ClearGrass/BranHardware/README.md

# BranHardware
BranHardware

## 2015-05-17

###Pinmap文件夹 存放管脚说明
###SCH   文件夹 存放原理图
