ClearGrass/BranHardware/11BRANBB70F/11BRANBB70F_20171028生产文件/11BRANBB70F_20171028制板要求.docx

主板制板需求

1. 单板尺寸：长*宽：30*27.45mm，严格按照Keepout layer层切割；
2. 层数： 两层板，2层，两面贴片；
3. 板厚：1MM，公差：±10%mm；
4. 材质：FR-4;
5. 铜箔厚度：完成铜厚1OZ；
6. 阻焊：字符颜色：白色；
7. 出货方式：拼板；
8. 过孔盖油；
9. 绿油阻焊；
10. 焊盘喷镀：沉金；
11. 测试：需要飞针测试；
12. 需要加贵司标记与年周；
13. 切割方式：VCUT；
14. Mark点生成需要做成如下：

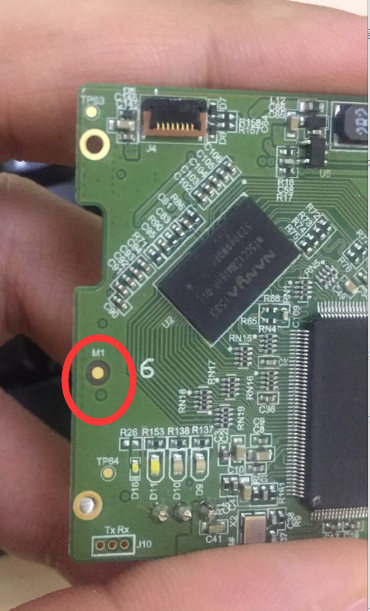
[picture p1: figure]

15. 拼板方式：

6*5;

设计参考拼板参考文件夹中的工作稿；主控板Mark点放在拼板短边一侧；

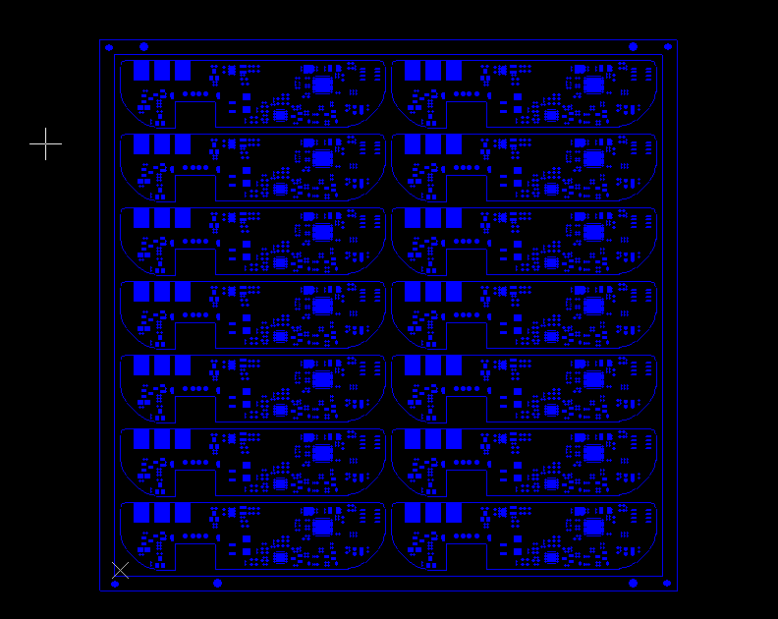
[picture p2: figure]

关于上述拼板文件，有几个问题点：

1） Mark点左下做防呆即可，其他三个Mark点距离板边的位置需要一致；
2） 定位孔需要距离板边距离一致；
3） 单板之间的间距可以参考拼板文件设计，但邮票孔换成VCUT；

另，添加以下其他要求：

1） 拼板文件需要将钻孔层工艺边的定位孔移至gtp以及gpb钢网文件中；
2） 如下图，需要在gto文件添加数量标示，从左至右以此类推。且gto与gpo文件需要加TOP和BOT丝印标记；

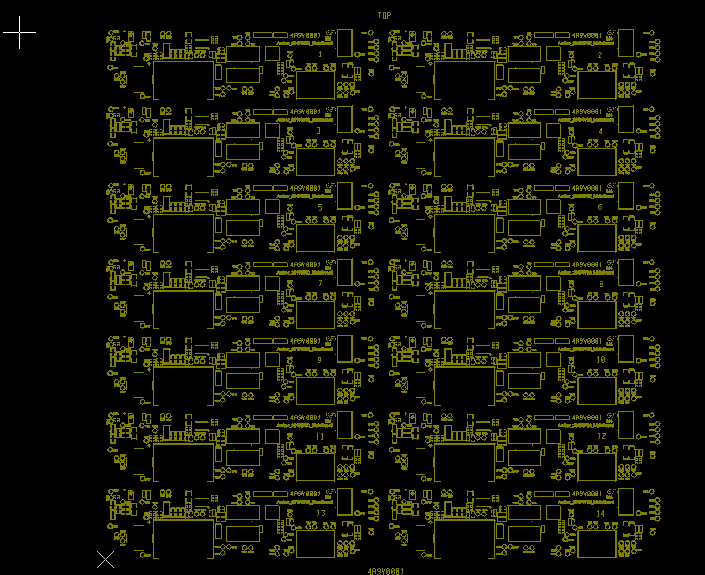
[picture p3: figure]

16. 出货方式：

拼板出货；

17. 数量：

与我司王丽娜确认。

18. 制板过程中若有疑问，请不要自行制板，请立刻联系我。谢谢！！

联系人：倪昭君，联系电话：15618636793；
