ClearGrass/BranHardware/11BRANBB70F/11BRANBB70F_20171028生产文件/变更说明.docx

1、仅图示三个定位孔直径变更，又1.2mm变更为1.05mm；

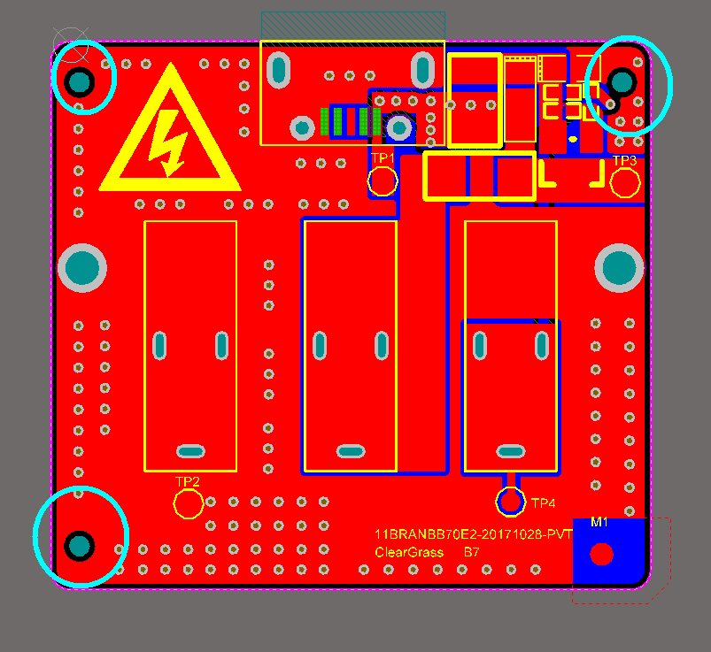
[picture p4: figure]

2、将板名称由11BRANBB70E改为11BRANBB70F
