ClearGrass/BranHardware/11BRANMB10H3/主板/11BRANMB10H3制板文件/制板要求.docx

主板制板需求:

1. 制程能力：

过孔：内径8mi，外径16mil，导线间距4mil；

2. 单板尺寸：长*宽：91.4*48mm，严格按照Keepout layer层切割；
3. 层数：六层板，两面贴片；

叠层结构：

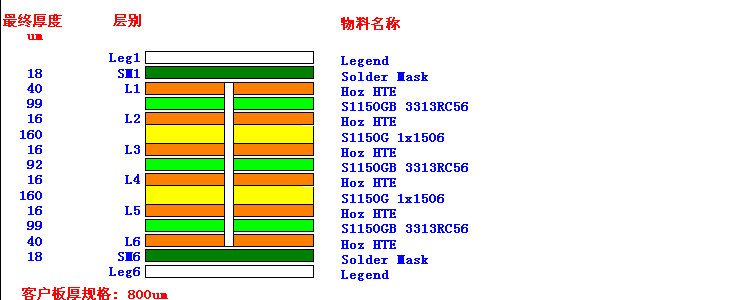
[picture p5: figure]

4. 板厚：0.8MM，公差：±10%mm；
5. 材质：FR-4; 无卤无铅；
6. 铜箔厚度：完成铜厚1OZ；
7. 字符颜色：白色；
8. 线路阻抗：必须按文件要求，无明确要求的可忽略；
9. 出货方式：拼板2*3 ,纵向间隔需要做2MM；
10. 过孔盖油；
11. 绿油阻焊；
12. 焊盘喷镀：沉金；
13. 测试：需要飞针测试；
14. 需要加贵司标记与年周；
15. 切割方式：邮票孔连筋；
16. 拼板方式：

参考拼板参考Gerber6e160885h0文件夹内工作稿；

设计参考《拼板设计》文件；主控板Mark点放在拼板短边一侧；


关于上述拼板文件，有几个问题点：

1） Mark点左下做防呆即可，其他三个Mark点距离板边的位置需要一致；
2） 定位孔需要距离板边距离一致；
3） 单板之间的间距可以参考拼板文件设计，但邮票孔换成VCUT；

另，添加以下其他要求：

1） 拼板文件需要将钻孔层工艺边的定位孔移至gtp以及gpb钢网文件中；
2） 如下图，需要在gto文件添加数量标示，从左至右以此类推。且gto与gpo文件需要加TOP和BOT丝印标记；


17. 出货方式：

拼板出货；

18. 数量：

10Pcs；

19. 制板过程中若有疑问，请不要自行制板，请立刻联系我。谢谢！！

联系人：倪昭君，联系电话：15618636793；
