ClearGrass/BranHardware/11BRANMB10H3/温湿度FPC/11BRANSEB30E2_20171028制板文件/变更记录.docx

1、 为配合H3版本结构更改，新设计的一款温湿度FPC;
2、 尺寸由：L*W=24.889*7.236变更为：L*W=19.903*7mm;
3、 附图

旧：

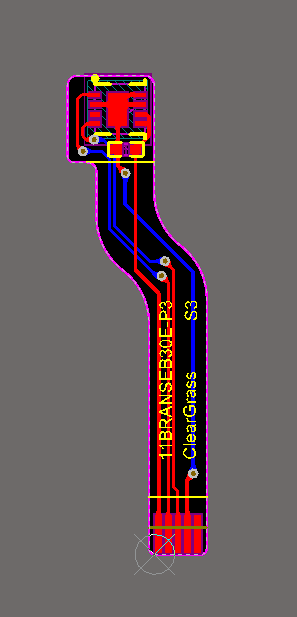
[picture p7: figure]

新：

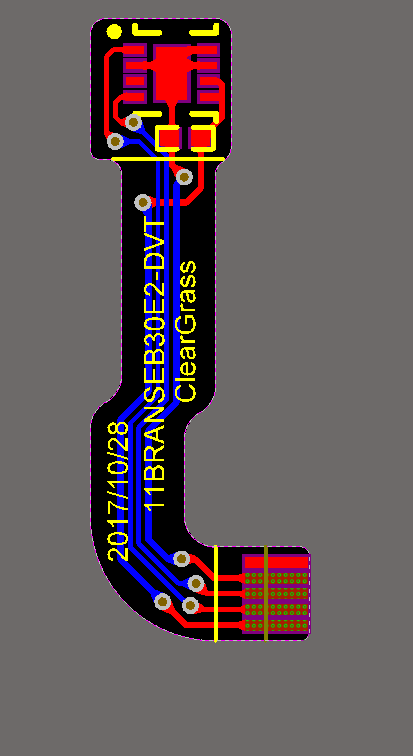
[picture p8: figure]
