ClearGrass/BranHardware/11BRANMB10G/Temp Sensirion assy FPC/结构/外接传感器.pptx

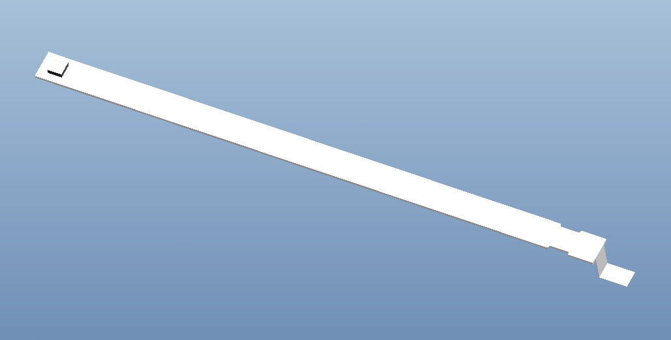
[picture p9: figure]

传感器位置

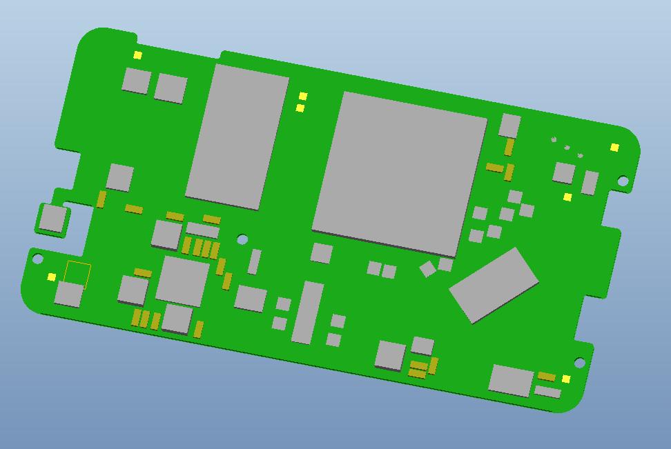
[picture p10: figure]

卡槽

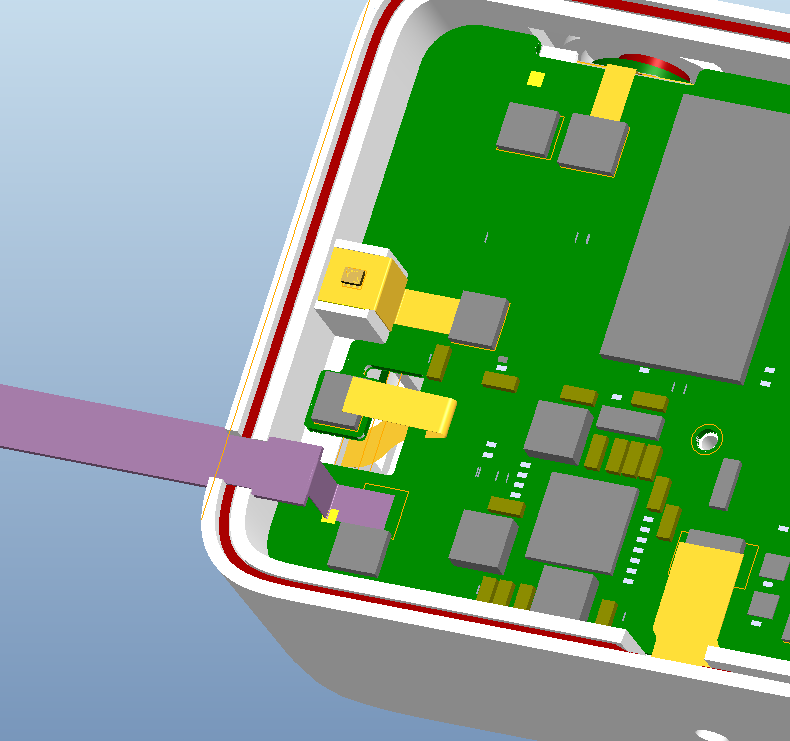
[picture p11: figure]

补强板长度100mm，宽度5mm
卡槽处与产品外壳开口处固定，屏幕压紧
防止FPC连接器脱落

连接器位置

## Slide 2

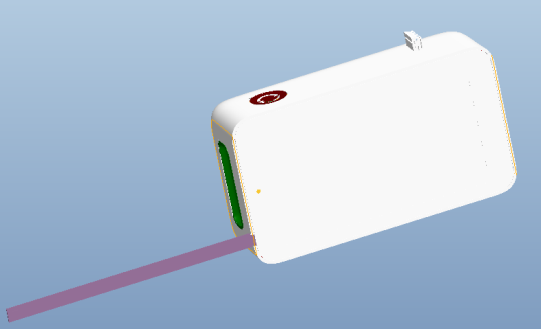
[picture p12: figure]
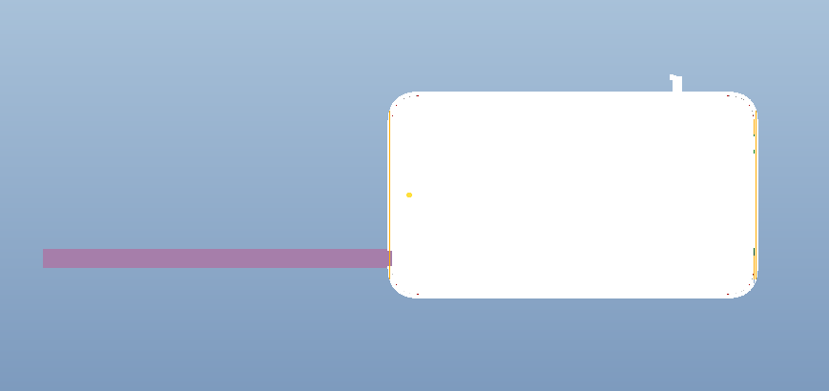
[picture p13: figure]

91mm

10mm

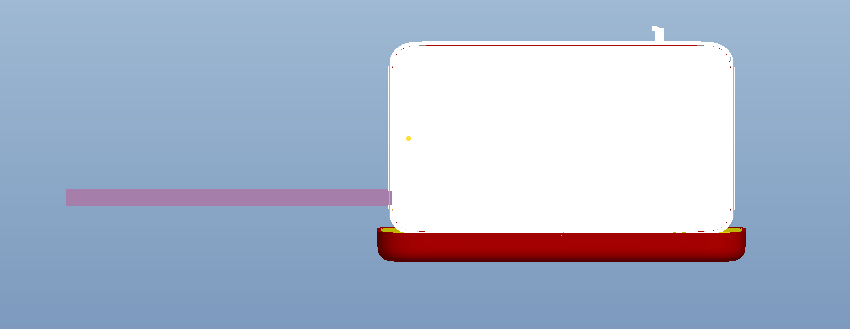
[picture p14: figure]

18mm
