ClearGrass/BranHardware/11BRANMB10H3/主板/11BRANMB10H3制板文件/阻抗匹配要求.docx

一、 差分：

1）95±10% ohm阻抗匹配：

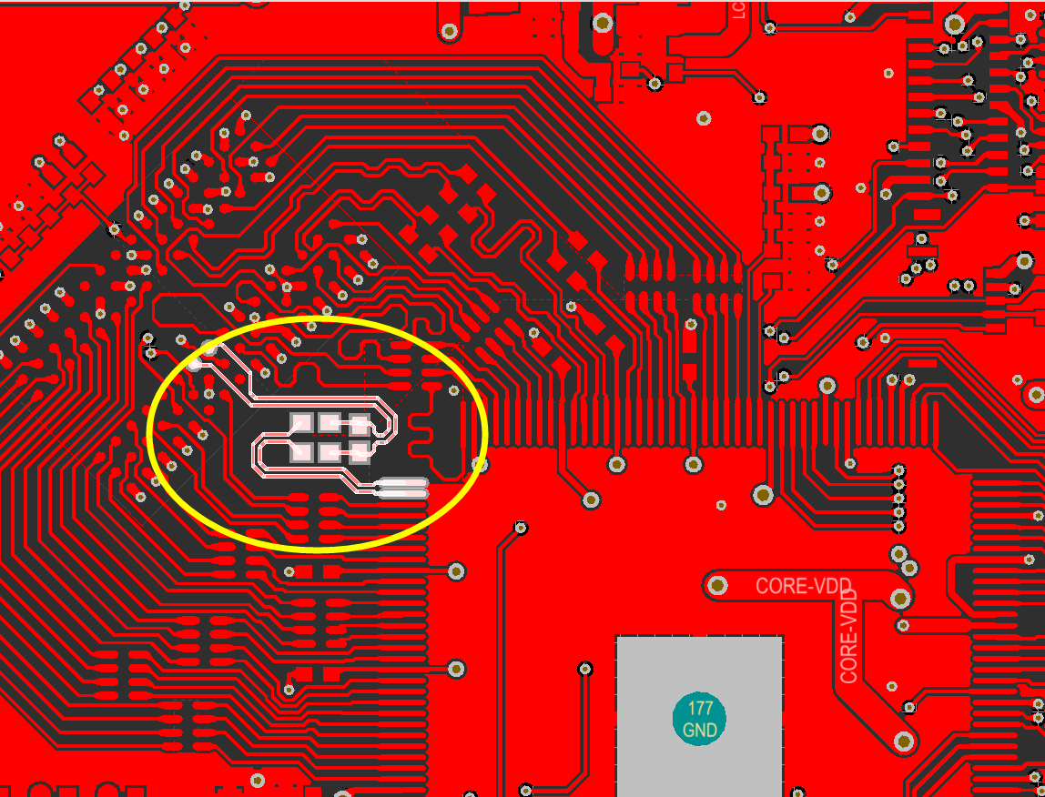
[picture p23: figure]

2）

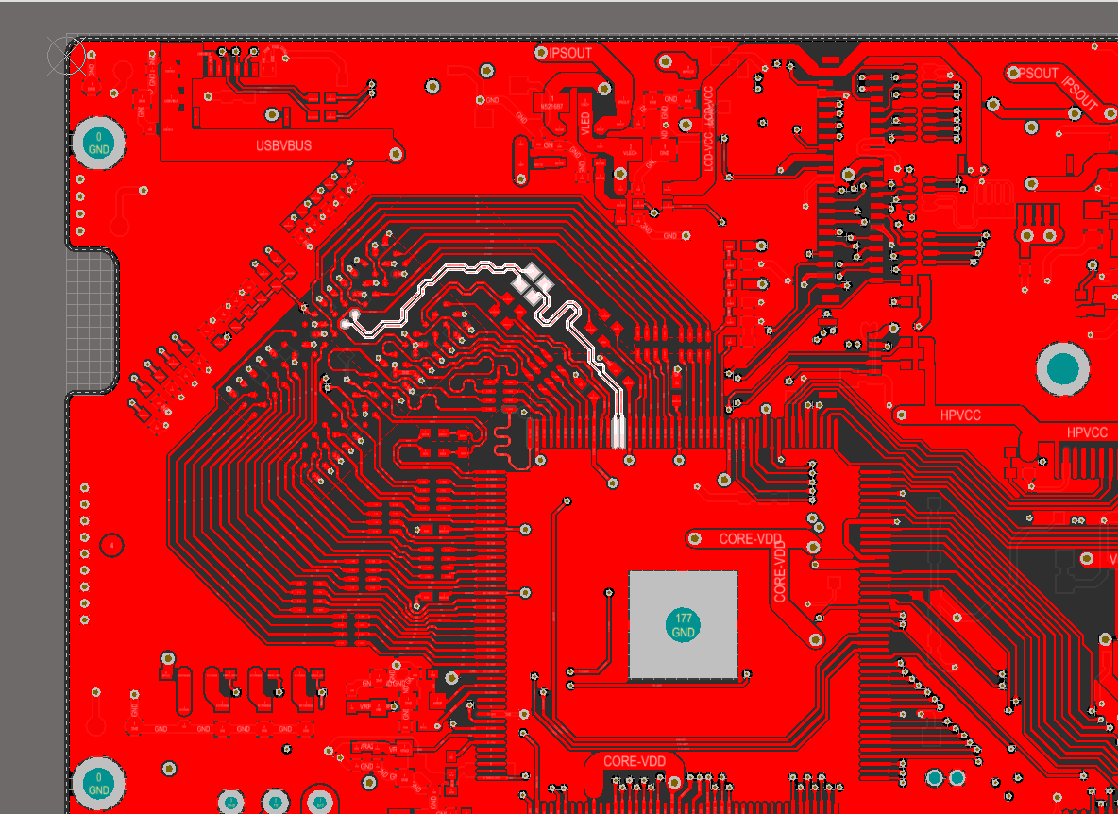
[picture p24: figure]

3）

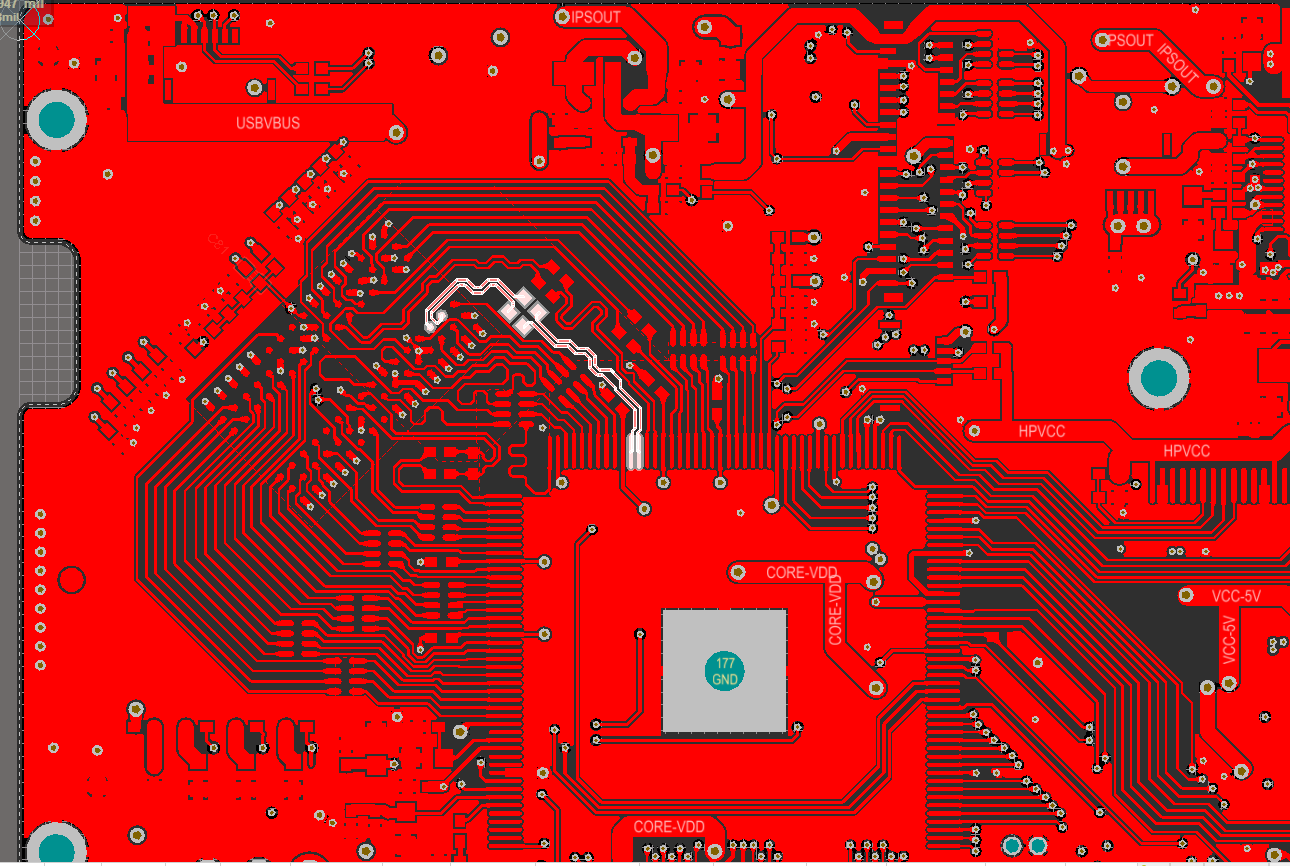
[picture p25: figure]

2. 90±10% ohm阻抗匹配：

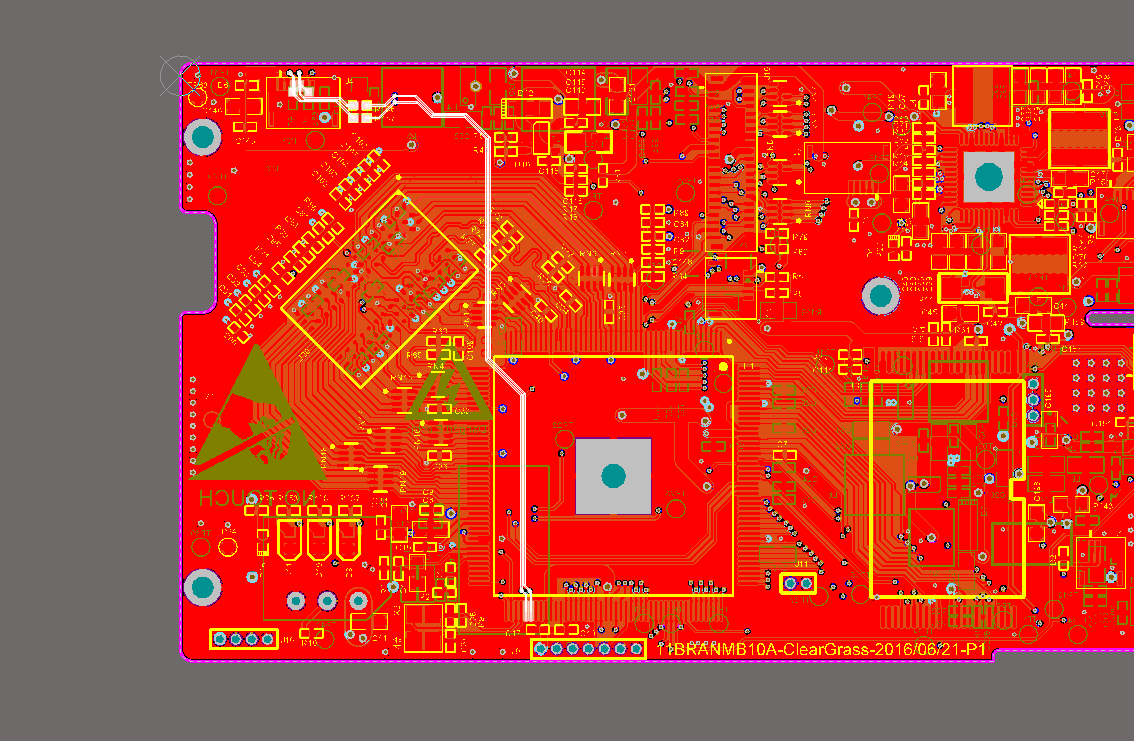
[picture p26: figure]

二、单端阻抗匹配

1. 45±10% ohm；

1）内存部分：

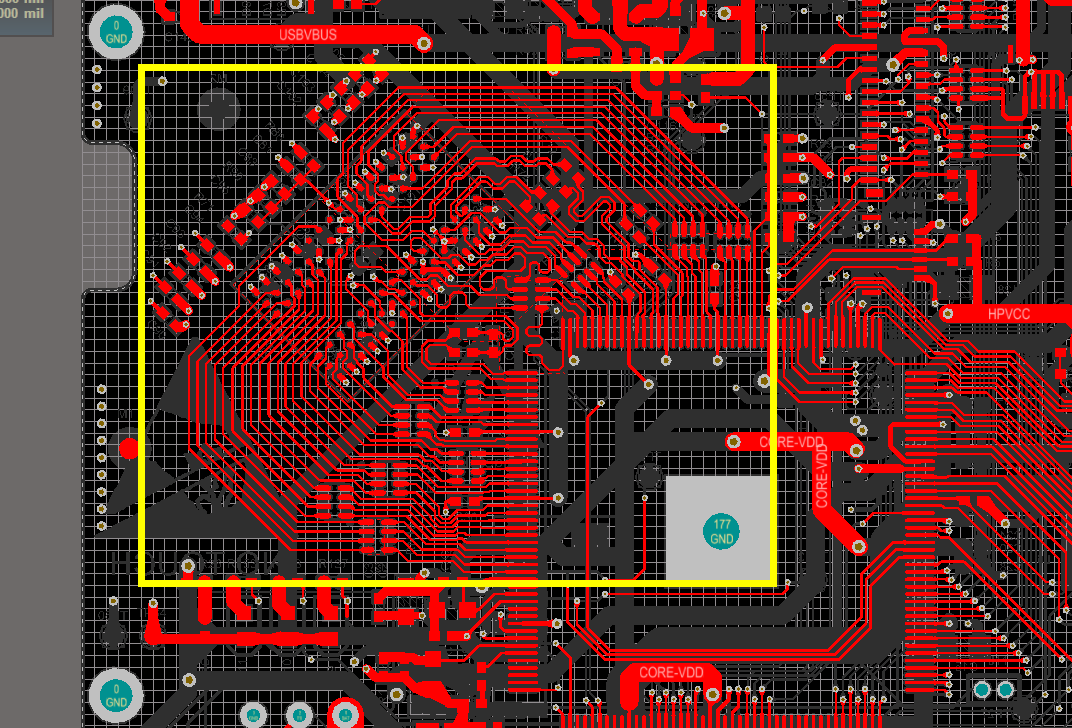
[picture p27: figure]

2）SDIO部分：

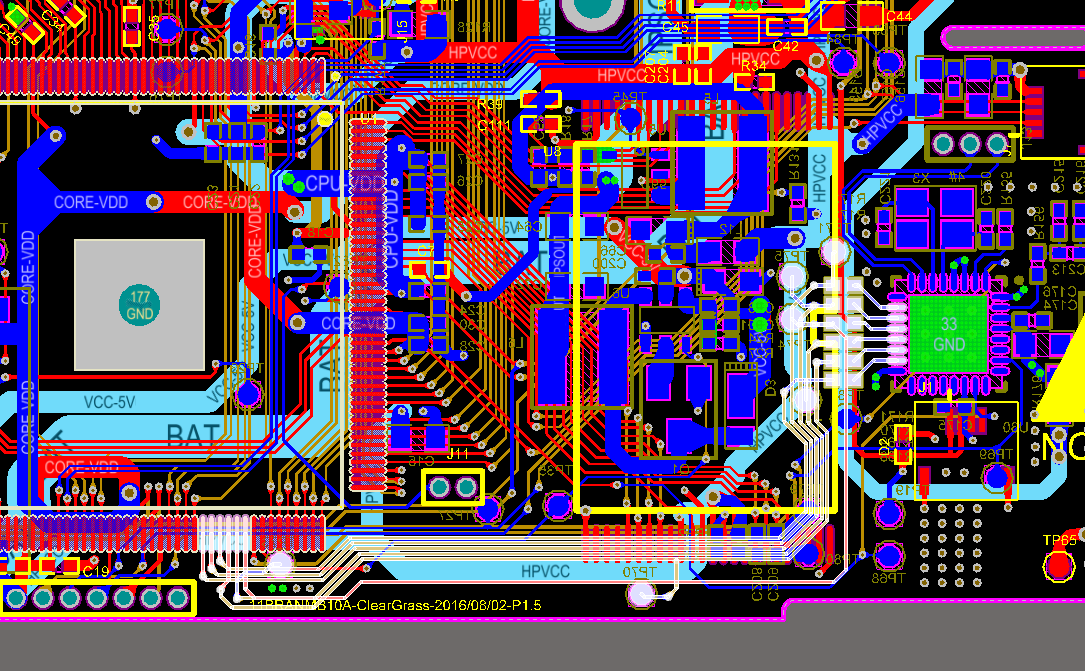
[picture p28: figure]

2. 50±10% ohm；

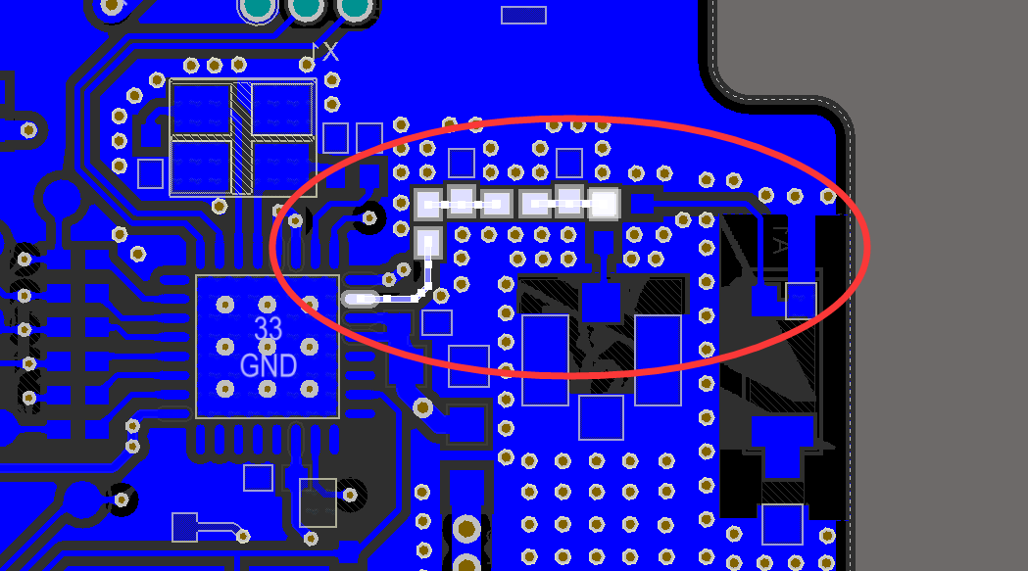
[picture p29: figure]
