ClearGrass/BranHardware/11BRANMB10G/11BRANMB10GSMT文件/01BOM/Bran SMT BOM20170921.xlsx

Sheet: SMT MB BOM
青萍科技（北京）有限公司
BILL OF MATERIAL
DOCUMENT NO. |  | BRAN_007 |  | HWID | N/A |  | AUTHOR |  | REV. | G
Product Name |  | BRAN |  | SWID | N/A |  | BOM Type |  | DATE | 2017-09-21
Item | ClearGrass P/N | 中文品名 | 商品编码 | Description |  | Supplier P/N | Supplier | Usage | Location | Weight (mg/pcs) | Critical Component
0 | 11BRANMB10G | 主板 |  | MB_ASSY_Rev.G/DVT |  |  | 卓达 | 1
1 | R0000R0402 | 电阻 |  | 0402 Jump |  | WR04X000 PTL | walsin | 6 | R2,R9,R151,R158,R156,R157,
2 | R0001R0402 | 电阻 |  | 0402 1R00 1% |  | WR04W1R00FTL | walsin | 2 | R14,R15
3 | R04R990402 | 电阻 |  | 0402 4R99 1% |  | WR04W4R99FTL | walsin | 1 | R50
4 | R0024R0402 | 电阻 |  | 0402 24R0 1% |  | WR04X24R0FTL | walsin | 8 | R65,R68,R72,R73,R74,R75,R76,R77
5 | R0033R0402 | 电阻 |  | 0402 33R0 1% |  | WR04X33R0FTL | walsin | 4 | R44,R45,R46,R54
6 | R0200R0402 | 电阻 |  | 0402 200R 1% |  | WR04X2000FTL | walsin | 6 | R168,R169,R170,R171,R172,R173
7 | R0240R0402 | 电阻 |  | 0402 240R 1% |  | WR04X2400FTL | walsin | 2 | R71,R94
8 | R0510R0402 | 电阻 |  | 0402 510R 1% |  | WR04X5100FTL | walsin | 1 | R28
9 | R0001K0402 | 电阻 |  | 0402 1K00 1% |  | WR04X1001FTL | walsin | 4 | R3,R4,R22,R177
10 | R0002K0402 | 电阻 |  | 0402 2K00 1% |  | WR04X2001FTL | walsin | 4 | R86,R89,R90,R91
11 | R002K20402 | 电阻 |  | 0402 2K20 1% |  | WR04X2201FTL | walsin | 2 | R5,R6
12 | R004K70402 | 电阻 |  | 0402 4K70 1% |  | WR04X4701FTL | walsin | 2 | R7,R8
13 | R0010K0402 | 电阻 |  | 0402 10K0 1% |  | WR04X1002FTL | walsin | 16 | R34,R39,R55,R79,R80,R81,R99,R129,R130,R131,R179，R194，R196,R197,R199,R209
14 | R0012K0402 | 电阻 |  | 0402 12K0 1% |  | WR04X1202FTL | walsin | 1 | R155
15 | R0047K0402 | 电阻 |  | 0402 47K0 1% |  | WR04X4702FTL | walsin | 2 | R21,R23,~~R211~~ | `
16 | R0100K0402 | 电阻 |  | 0402 100K 1% |  | WR04X1003FTL | walsin | 5 | R12,R17,R180,R190,R181
17 | R0150K0402 | 电阻 |  | 0402 150K 1% |  | WR04X1503FTL | walsin | 1 | R13
18 | R0200K0402 | 电阻 |  | 0402 200K 1% |  | WR04X2003FTL | walsin | 3 | R1,R19,R188
19 | R0442K0402 | 电阻 |  | 0402 442K 1% |  | WR04X4423FTL | walsin | 1 | R18
20 | R001M80402 | 电阻 |  | 0402 1.8M 1% |  | WR04W1804FTL | walsin | 1 | R189
21 | R0000R0603 | 电阻 |  | 0603 Jump |  | WR06X000 PTL | walsin | 5 | R160,R176，R195，R198，R213
22 | R030MR1206 | 电阻 |  | 1206 R030 1% |  | WW12WR030FTL | walsin | 1 | R11
23 | RA024R0402 | 电阻 |  | 044R 24R0 1% |  | WA04X24R0FTL | walsin | 4 | RN1,RN3,RN5,RN6
24 | RA033R0402 | 电阻 |  | 044R 33R0 1% |  | WA04X33R0FTL | walsin | 6 | RN4,RN15,RN16,RN17,RN18,RN19
25 | RA100R0402 | 电阻 |  | 044R 100R 1% |  | WA04X1000FTL | walsin | 6 | RN2,RN7,RN8,RN9,RN10,RN11
26 | C006P80402 | 电容 |  | 0402 NPO 6.8pF +-0.25F 50V |  | 0402N6R8C500CT | walsin | 1 | C213
27 | C002P40402 | 电容 |  | 0402 NPO 2.4pF +-0.25pF 50V |  | 0402N2R4C500CT | walsin | 1 | C216
28 | C003P30402 | 电容 |  | 0402 NPO 3.3pF +-0.25pF 50V |  | 0402N3R3C500CT | walsin | 2 | C220,C221
29 | C0010P0402 | 电容 |  | 0402 NPO 10pF +-5% 50V |  | 0402N100J500CT | walsin | 1 | C109
30 | C0018P0402 | 电容 |  | 0402 NPO 18pF +-1% 50V |  | 0402N180F500CT | walsin | 2 | C37,C38
31 | C0047P0402 | 电容 |  | 0402 NPO 47pF +-5% 50V |  | 0402N470J500CT | walsin | 2 | C43,C58
32 | C0001N0402 | 电容 |  | 0402 X7R 1000pF +-5% 50V |  | 0402B102J500CT | walsin | 3 | C48,C56,C70
33 | C0010N0402 | 电容 |  | 0402 10nF +-5% 50V |  | 0402B103K500CT | walsin | 3 | C51,C65,C237
34 | C100N7R0402 | 电容 |  | 0402 X7R 100nF +-10% 10V |  | 0402B104K100CT | walsin | 61 | C3,C5,C7,C9,C10,C17,C19,C24,C25,C26,C27,C29,C30,C31,C35,C36,C81,C82,C83,C84,C85,C86,C87,C88,C89,C90,C91,C92,C93,C94,C95,C96,C97,C98,C99,C100,C101,C102,C103,C104,C105,C106,C111,C120,C123,C145,C148,C154,C156,C158,C176,C207,C209，C227，C228,C240,C241,C242,C248,C238，C253
35 | C100N5R0402 | 电容 |  | 1005（0402） X5R 100nF +-10% 50V |  | GRM155R61H104KE14D | murata | 1 | C116
36 | C01U5R0402 | 电容 |  | 0402 X5R 1000nF +-10% 10V |  | 0402X105K100CT | walsin | 21 | C1,C16,C18,C21,C22,C23,C28,C33,C34,C42,C49，C59,C60,C62,C71,C117,C175,C235,C236,C204，C208,
37 | C4U75R0603 | 电容 |  | 0603 X5R 4700nF +-10% 10V |  | 0603X475K100CT | walsin | 18 | C4,C15,C20,C39,C41,,C50,C61,C63,C64,C67,C69,C142,C146,C152,C155,C157,C249,C252
38 | C10U5R0603 | 电容 |  | 0603 X5R 10uF +-10% 10V |  | 0603X106K100CT | walsin | 17 | C2,C8,C40,C44,C45,C46,C47,C53,C54,C55,C57,C68,C121,C122,C174，C225，C251
39 | CT10U7R0603 | 钽电容 |  | TCM1A106M8R-O2 |  | TCM1A106M8R-O2 | ROHM | 1 | C52
40 | CT22U7R0603 | 钽电容 |  | TCSM1A226M8R-02 |  | TCSM1A226M8R | ROHM | 3 | C66,C159,C226
41 | L002NH0402 | 电感 |  | MLCI1005（0402）2.0nH +-0.1nH |  | WLCM1005Z0B2N0TB | walsin | 1 | C215
42 | L02UH24018 | 电感 |  | 4018 2.2uH +-20% 3A 45mR |  | MNR-4018-2R2M-L-XW | Mag | 4 | L1,L3,L5,L18
43 | L04UH74018 | 电感 |  | 4018 4.7uH +-20% 2.0A 70mR |  | MNR-4018-4R7M-H-XW | Mag | 2 | L2,L4
44 | L0100UH4018 | 电感 |  | 4018 10uH +-20% 1.3A 170mR |  | MNR-4018-100M-I-XW | Mag | 1 | L7
45 | L01A30603 | 磁珠 |  | 空白（BLM18KG601SN1D） |  | BLM18KG601SN1D | murata | 3 | L12,L13,L19
46 | D10MA1006 | 肖特基二极管 |  | RB160VAM-40TR |  | TUMD2M_RB160VAM-40TR | ROHM | 2 | D12，D18
47 | D03P106037 | TVS二极管 |  | VMNZC6.8CM8XT2R |  | VMNZC6.8CST2RA | ROHM | 2 | D7,D8
48 | DESD6V0201 | TVS二极管 |  | VS5V0BC1EST15R |  | VS5V0BC1EST15R | ROHM | 6 | D2,D4,D13,D15,D19，D20
49 | DESD9V2SOD123 | TVS二极管 |  | RSA5M |  | RSA5M | ROHM | 3 | D5,D6,D14
50 | A2450M3216 | 天线 |  | 3216 Type Antenna |  | RFECA3216060A1T | walsin | 1 | A1
51 | CN37361FPC | 连接器 |  | 046298704220883+（FPC_CONNECTOR_Bottom_0.5MM_3.7*3.6*1） |  | 046298704220883+ | 京瓷 | 1 | J1
52 | CN42361FPC | 连接器 |  | 5034800500 |  | 503480-0500 | Molex | 4 | J5,J7,J17，J18
53 | CN47361FPC | 连接器 |  | 5034800600 |  | 503480-0600 | Molex | 1 | J3
54 | CN39260BTB | 连接器 |  | 5035520620 |  | 5035480620 | Molex | 1 | J15
55 | CN57361FPC | 连接器 |  | 046298708220883+（FPC_CONNECTOR_Bottom_0.5MM_5.7*3.6*1） |  | 046298708220883+ | 京瓷 | 1 | J4
56 | CN10020BTB | 连接器 |  | 5033044240 |  | 5033044240 | Molex | 1 | J16
57 | CN10535FPC | 连接器 |  | 046298708220883+（WTB_CONNECTOR_10.5*3.5*4.5） |  | CI1506M1HR0-NH | 瀚荃股份 | 1 | J6
58 | CN16742FPC | 连接器 |  | 2581WR3- |  | S3B-EH | JST | 1 | J2
59 | ICCPULQPF176 | 集成电路 |  | E2090CA |  | R8 | 全志 | 1 | U1
60 | ICDDR32GVGBGA | 集成电路 |  | IC_DDR3_128*16_1600Mbps_96-Ball_VFBGA |  | NT5CC128M16IP-DII | NanYa | 1 | U2
60.1 | ICDDR2GVGBGA | 集成电路 |  | IC_DDR3_128*16_1600Mbps_96-Ball_VFBGA |  | NT5CC128M16IP-DI | NanYa | 1 | U2
61 | ICPMUQFN32 | 集成电路 |  | F9088CB |  | AXP209 | 芯智汇 | 1 | U3
62 | ICBUCKSOT235 | 集成电路 |  | AP3410KTR-G1 |  | AP3410KTR-G1 | Diodes | 2 | U4,U5
62.1 | ICBUCKRTSOT235 | 集成电路 |  | 1A, 1.5MHz 同步降压型 DC/DC 转换器 |  | RT8059GJ5 | RichTek | 2 | U4,U5
63 | ICWIFIQFN32 | 集成电路 |  | ESP8089（IC_Wi_Fi_IEEE-802.11 b/g/n_SDIO-Interface_QFN32） |  | ESP8089 | 乐鑫 | 1 | U7
64 | ICNAND2GTSOP48 | 集成电路 |  | MT29F2G08ABAEAWP-IT:E （IC_NandFlash_8*256bit_3.3V_TSOP48） |  | MT29F2G08ABAEAWP-IT:E | 镁光 | 1 | U8
65 | ICWLEDDRDFN2*2 | 集成电路 |  | SGM3756YTDI6G/TR |  | SGM3756YTDI6G/TR | 圣邦威 | 1 | U9
66 | ICLIS2DHGA12 | 集成电路 |  | G-SENSOR |  | LIS2DH12 | ST | 1 | U10
67 | ICBOOSTSOT236 | 集成电路 |  | DC/DC BOOST |  | SGM66051-ADJYTN6G/TR | 圣邦威 | 1 | U15
68 | ICLDO18SC70 | 集成电路 |  | LDO/1.8V |  | MAX8891EXK18+T | 美信 | 1 | U19
68.1 | ICSLDO18SC70 | 集成电路 |  | LDO/1.8V |  | SGM2019-1.8YC5G/TR | 圣邦威 | 1 | U19
69 | ICLOGICDQE | 集成电路 |  | LOGIC |  | TXS0102DQER | TI | 1 | U20
69.1 | SGM4553YX | 集成电路 |  | LOGIC |  | SGM4553YXD08G/TR | 圣邦威 | 1 | U20
70 | ICRTCMSOP8 | 集成电路 |  | RTC Timer |  | AT8563S | 武汉芯景 | 1 | U16
71 | ICTEMPQFN8 | 集成电路 |  | Temp Sensor |  | STS30 | 盛思睿 | 1 | U21
72 | CR026M3225 | 晶振 |  | E3SB26E002703E（CRYSTAL_26M_±10PPM_16PF_-20℃~75℃_3225_） |  | E3SB26E002703E | 鸿星 | 1 | X1
73 | CR024M3225 | 晶振 |  | E3SB24E002700ECRYSTAL_24M_±20PPM_12PF_-40℃~85℃_3225_） |  | E3SB24E002700E | 鸿星 | 1 | X2
74 | C432K7683125 | 晶振 |  | 32.768K/12.5pF/±10ppm |  | ETST003272700E | 鸿星 | 1 | X3
75 | PCBBRANMB1G | PCB |  | PCB_FR4_0.8MM_Green_Oil_Six_Layered_Plated_turmeric |  |  | 普诺威 | 1
75.1 | PCB200001P | PCB
END
 |  |  |  |  | `

Sheet: History
青萍科技 |  |  | Doc. No: | Bran_006 | Product Model: |  | Bran
 |  |  | VER.: | F |  | Date: | 2017-08-19
＊＊＊＊＊＊ Revise History ＊＊＊＊＊＊
 | Version | ECN NO. |  | Section |  |  | Remarks
 |  |  |  |  |  |  | 201611/19
 |  | 11BRANMB10C
 |  |  |  | R0000RO402去除R47、R156、R160，数量改为5；
 |  |  |  | R0001KO402去除R49，R5，R6，新增R3、R4、R177，数量改为4；
 |  |  |  | 新增R002K20402 R49，数量为1；
 |  |  |  | R004K7O402新增R5，R6，R184，R185，去除R3，R4，数量改为6；
 |  |  |  | R0010KO402新增R179，数量改为13；
 |  |  |  | 新增R0020K0402 R183，对应供应商料号WR04W2R2FTL，数量为1；
 |  |  |  | R0047KO402新增R47，数量改为3；
 |  |  |  | R0100KO402新增R180、R181、R182，数量改为5；
 |  |  |  | C01U5R0402新增C222，数量改为20；
 |  |  |  | C10U5R0603新增C223，数量改为20；
 |  |  |  | L01A30603新增L17，数量改为6；
 |  |  |  | CN47361FPC去除J16，数量改为1；
 |  |  |  | 去除CN12835FPC J16，对应供应商料号FH26-41S-0.3SHW(05)；
 |  |  |  | 新增CN10020BTB J16，对应供应商料号5033044240；
 |  |  |  | ICDDR32GVGBGA料号由U29改为U2；
 |  |  |  | ICWIFIQFN32料号由U30改为U7；
 |  |  |  | ICWBOOSTSOT236料号由U10改为U9；
 |  |  |  | ICGSENSORLGA12料号由U12改为U10；
 |  |  |  | D03P106037 D17去除；
 |  |  |  | CR026M3225料号由X3改为X1；
 |  |  |  | 空焊：R32、R35、R178、R175、C215、C216
 |  |  |  | R156 改成0402封装，并将对应数量改为7
 |  |  |  | 删除R50改动，仍保持其4.99R
 |  |  |  | R136 0603封装删除
 |  |  |  | C52删除0603陶瓷封装
 |  |  |  | C76删除0603陶瓷封装
 |  |  |  | 25行，R0000RO603 usage改为7
 |  |  |  | 41行，C10U5R0603 usage改为18
 |  |  |  | NAND改为2G
 |  |  |  | C10U5R0805供应商料号改为0805X106K500CT；
 |  |  |  | 修改不正确的bom，如4.99R改成4R99等 |  |  | 2016-08-19
 |  |  |  | 修改SEB 0.1uF电容青萍料号 |  |  | 2016-08-19
 |  |  |  | 修改KB 电容青萍料号 |  |  | 2016-08-19
 |  |  |  | 修改OL 电容青萍料号 |  |  | 2016-08-19
 |  |  |  | 修改BB 青萍料号 |  |  | 2016-08-19
 |  |  |  | 修改错误的O改为0 |  |  | 2016-08-19
 |  |  |  | L01A30603新增L17，数量改为6；
 |  |  |  | L14修改为R0603 0欧姆电阻，并修改对应数量需求 |  |  | 2016-08-29
 |  |  |  | C109 10pF增加上件 |  |  | 2016-08-29
 |  |  |  | 我们不用台湾嘉硕的晶振了,全部换成鸿星的了. 鸿星的型号如下: 26M E3SB26E002703E、24M E3SB24E002700E |  |  | 2016-11-01
 |  |  |  | 型号03A-LPSN 供应商龙雨薇 这个变更为JST的 S3B-EH
 |  |  |  | D003M10502删除； |  |  | 2016-11-01
 |  |  |  | L20由L01A30603改为R0000R0603； |  |  | 2016-11-04
 |  |  |  | L002NH0402对应原厂料号变更为WLCM1005Z0B2N0TB； |  |  | 2016-11-04
 |  |  |  | 新增ICDDR2GVGBGA 商业级替代物料； |  |  | 2016-11-04
 |  |  |  | QPMOSSOT23青萍料号变更为M030V2928； |  |  | 2016-11-07
 |  |  |  | AP3032KTR-G1青萍料号变更为ICBUCKTSOT236； |  |  | 2016-11-08
 |  |  |  | M030V2928描述改为RRR030P03TL； |  |  | 2016-11-08
 |  |  |  | 删除R132、R133电阻R0010K0402； |  |  | 2016-11-09
 |  |  |  | 删除C200电容C01U5R0402； |  |  | 2016-11-09
 |  |  |  | 删除C73钽电容CT10U7R0603； |  |  | 2016-11-09
 |  |  |  | 删除R0000R0603 R201 |  |  | 2016-11-09
 |  |  |  | 增加R0000R0603 R197 |  |  | 2016-11-09
 |  |  |  | 增加R202缺330K/1%；R0330K0402 |  |  | 2016-11-17
 |  |  |  | 增加C52缺10uF，钽电容；CT10U7R0603 |  |  | 2016-11-17
 |  |  |  | 增加R9 缺0R/1%； R0000R0402 |  |  | 2016-11-17
 |  |  |  | 增加R191 R0000R0402 |  |  | 2016-11-18
 |  |  |  | 增加L02UH24018 L18位号，去除L04UH74018 L18； |  |  | 2016-11-19
 |  | 11BRANMB10E |  | 删除ICTEMPQFN8 盛思睿STS30 U20、U21； |  |  | 2016-12-30
 |  |  |  | 删除ICLDO33DGR TI LP2951-33DGR U22； |  |  | 2016-12-30
 |  |  |  | 删除ICLDO15SOT235 圣邦威 MG2019-1.5 U19； |  |  | 2016-12-30
 |  |  |  | 删除ICSPIADCSOT236 美信 MAX11663； |  |  | 2016-12-30
 |  |  |  | 增加ICLOGICDQE TI TXS0102 U20； |  |  | 2016-12-30
 |  |  |  | 增加ICLDO18SC70 美信 MAX8891EXK18+T U19； |  |  | 2016-12-30
 |  |  |  | 删除L01A30603 L19,L01A30603数量变为3； |  |  | 2016-12-30
 |  |  |  | 删除CN47361FPC Molex 503480-0600 J5； |  |  | 2016-12-30
 |  |  |  | 增加CN47361FPC Molex 503480-0600 J3； |  |  | 2016-12-30
 |  |  |  | 删除CN77361FPC Molex 503480-1000 J3； |  |  | 2016-12-30
 |  |  |  | 增加CN42361FPC Molex 503480-0500 J5，J17；CN42361FPC数量变为3； |  |  | 2016-12-30
 |  |  |  | 增加DESD6V0201 ROHM VS5V0BC1EST15R D2,D4,D13,D15,D19,数量为5； |  |  | 2016-12-30
 |  |  |  | 增加DESD9V2SOD123 ROHM RSA5M D5,D6,D14，数量为3； |  |  | 2016-12-30
 |  |  |  | 删除D03P106037 ROHM VMNZC6.8CST2RA D2,D4,D13,D15,D19，D5,D6,D14，数量变为2； |  |  | 2016-12-30
 |  |  |  | 删除M030V2928 ROHM RRR030P03TL； |  |  | 2016-12-30
 |  |  |  | 删除RA047R0402 walsin WA04X47R0FTL； |  |  | 2016-12-30
 |  |  |  | 删除R0200K0402 walsin WR04X2003FTL R161，R200；数量变更为3； |  |  | 2016-12-30
 |  |  |  | R0000R0402 walsin WR04X000 PTL删除R9，数量变更为6； |  |  | 2016-12-30
 |  |  |  | R0001K0402 walsin WR04X1001FTL删除R199，数量变更为4； |  |  | 2016-12-30
 |  |  |  | 增加R002K20402 walsin WR04X2201FTL R5,R6，数量为2； |  |  | 2016-12-30
 |  |  |  | R004K70402 walsin WR04X4701FTL删除R5，R6，数量变更为4； |  |  | 2016-12-30
 |  |  |  | R0100K0402 walsin WR04X1003FTL删除R181,R198，增加数量R190,R210,R181,数量变更为7； |  |  | 2016-12-30
 |  |  |  | R0047K0402 walsin WR04X4702FTL增加R211，数量变更为4； |  |  | 2016-12-30
 |  |  |  | R0010K0402 walsin WR04X1002FTL删除R193，R162，R190；增加R196,R197,R199,,R209，数量变更为16； |  |  | 2016-12-30
 |  |  |  | R0000R0603 walsin WR06X000 PTL删除R128,R144,R145,R146,R147,R196，L20，R197；增加R198；数量变更为4； |  |  | 2016-12-30
 |  |  |  | 删除R0330K0402 walsin WR04X3303FTL R202； |  |  | 2016-12-30
 |  |  |  | C01U5R0402 walsin 0402X105K100CT C243,C242，数量变更为21； |  |  | 2016-12-30
 |  |  |  | C10U5R0603 walsin 0603X106K100CT 删除C229，数量变更为18； |  |  | 2016-12-30
 |  |  |  | C100N7R0402 walsin 0402B104K100CT删除C238，C239，C230，C231，，新增C242,C246,C248；数量变更为60； |  |  | 2016-12-30
 |  |  |  | CT22U7R0603 ROHM TCSM1A226M8R-02 删除C244，数量变更为3； |  |  | 2016-12-30
 |  |  |  | C4U75R0603 walsin 0603X475K100CT 增加C249，删除C49，数量保持17； |  |  | 2016-12-30
 |  |  |  | 增加C04U7R0402 walsin 0402X407K100CT C49，数量为1； |  |  | 2016-12-30
 |  |  |  | R0000R0402 walsin WR04X000 PTL增加R212，数量变更为7； |  |  | 2017-01-03
 |  |  |  | 删除R0000R0402 R174，数量变更为6 |  |  | 2017-01-18
 |  |  |  | 删除R0000R0805 R136，数量为0，删除walsin WR08X000 PTL |  |  | 2017-01-18
 |  |  |  | 删除CT22U7R0603 C244，数量改为3； |  |  | 2017-01-18
 |  |  |  | 删除ICBUCKTSOT236 Diodes AP3032KTR-G1 U9，数量改为0； |  |  | 2017-01-18
 |  |  |  | 新增ICWLEDDRDFN2*2 圣邦威 SGM3756 U9，数量改为1； |  |  | 2017-01-18
 |  |  |  | L01A30603 L17替换为L19； |  |  | 2017-01-18
 |  |  |  | C10U5R0603 删除C114，C223，增加C251 |  |  | 2017-01-18
 |  |  |  | 删除C10U5R0805 C113，数量改为0； |  |  | 2017-01-18
 |  |  |  | L0010U5040替换为L0100UH4018，位号仍然为L7； |  |  | 2017-01-18
 |  |  |  | R04R990402替换为R05R0402，位号仍然为R50； |  |  | 2017-01-18
 |  |  |  | 删除R04K990402 R49，数量变更为0； |  |  | 2017-01-18
 |  |  |  | R004K70402删除R184，R185，数量变更为2； |  |  | 2017-01-18
 |  |  |  | 删除R0075K0402 R183，数量变更为0； |  |  | 2017-01-18
 |  |  |  | R0047K0402删除R47，数量变更为3； |  |  | 2017-01-18
 |  |  |  | R0100K0402删除R182，数量变更为6； |  |  | 2017-01-18
 |  |  |  | C0001N0402删除C115，数量变更为3； |  |  | 2017-01-18
 |  |  |  | C01U5R0402删除C222，数量变更为20 |  |  | 2017-01-18
 |  |  |  | 增加ICSLDO18SC70替代物料，圣邦威 SGM2019-1.8YC5G/TR，料号为U19 |  |  | 2017-01-18
 |  |  |  | ICBOOSTSOT236圣邦威物料更新为SGM66051-ADJYTN6G/TR |  |  | 2017-01-19
 |  |  |  | ICWLEDDRDFN2*2圣邦威物料更新为SGM3756YTDI6G/TR |  |  | 2017-01-19
 |  |  |  | R0000R0402 中删除R174，增加R157 |  |  | 2017-01-20
 |  |  |  | R0100K0402 R136删除 |  |  | 2017-01-20
 |  |  |  | C100N5R0402 数量修改为60 |  |  | 2017-01-20
 |  |  |  | L002NH0402 删除C244，数量改为3 |  |  | 2017-01-20
 |  |  |  | D10MA1006 数量修改为3 |  |  | 2017-01-20
 |  |  |  | D10MA1006 location补充D12，D18数量填写2 |  |  | 2017-01-20
 |  |  |  | L0100UH4018 MNR-4018-100M-XW改为MNR-4018-100M-I-XW |  |  | 2017-01-23
 |  |  |  | R0000R0402增加位号R9； |  |  | 2017-01-23
 |  |  |  | C04U7R0402 C49替换为C4U75R0603 |  |  | 2017-02-08
 |  |  |  | R04R990402替换R005R0402 |  |  | 2017-02-08
 |  |  |  | R0100K0402 R210删除，数量变更为5 |  |  | 2017-02-27
 |  |  |  | C100N7R0402 walsin 0402B104K100CT删除C246；数量变更为59； |  |  | 2017-02-27
 |  |  |  | Logic新增圣邦威替代物料ICLOGICXTDFN |  |  | 2017-03-15
 |  |  |  | ICLOGICXTDFN变更为SGM4553YX |  |  | 2017-04-08
 |  |  |  | R0000R0402 R212去除； |  |  | 2017-06-21
 |  |  |  | R0047K0402 R211去除； |  |  | 2017-06-21
 |  |  |  | MC-100503035-R换成MC-100503036-R |  |  | 2017-07-24
 |  | 11BRANMB10F |  | R0000R0603 R213增加 |  |  | 2017-08-19
 |  |  |  | C100N7R0402 C238增加 |  |  | 2017-08-19
 |  |  |  | ICTEMPQFN8 U21增加 |  |  | 2017-08-19
 |  | 11BRANBB70B |  | R0100KO402 R5新增 |  |  | 2016-08-29
 |  |  |  | M10MR0605 Q2新增 |  |  | 2016-08-29
 |  |  |  | L501PB3126新增 |  |  | 2016-09-06
 |  |  |  | 修改R1位0805封装 |  |  | 2016-10-09
 |  |  |  | 删除R137、R138、R153 |  |  | 2016-10-25
 |  |  |  | 删除D9、D10、D11、D1 |  |  | 2016-10-25
 |  |  |  | 删除R20、R26、R9 |  |  | 2016-10-25
 |  |  |  | 删除L14、L15、L16 |  |  | 2016-10-25
 |  |  |  | 删除C72、U6、L6、D3、R24、R27、C201、C73、Q1 |  |  | 2016-10-25
 |  |  |  | 增加D18、C225、C227、L18、R190、U15、R189、R188、C226、C228 |  |  | 2016-10-25
 |  |  |  | 变更R49阻值为5.1K，变更R183阻值为75K |  |  | 2016-10-25
 |  |  |  | U10 DS_DA226变更为LIS2DH12 |  |  | 2016-10-25
 |  |  |  | 增加C240,D19 |  |  | 2016-10-25
 |  |  |  | 增加X3，C31，R194，U16 |  |  | 2016-10-25
 |  |  |  | 增加C235，R193，C236，C237,C238,C239,R195,R196,U20,U21 |  |  | 2016-10-25
 |  |  |  | 增加R199、R198、Q20、Q19，R161，R162，U14，RN20，RN21 |  |  | 2016-10-25
 |  |  |  | 华科的0402B103J500CT换成0402B103K500CT |  |  | 2016-10-25
 |  |  |  | 删除0734120110 |  |  | 2016-10-25
 |  |  |  | 增加DESD6V0201 VS5V0BC1EST15R ROHM D1 |  |  | 2017-01-18
 |  | 11BRANSEB30D |  | 新增ICVOCDFN2*2 U2 |  |  | 2016-11-01
 |  | 11BRANSEB30E |  | 删除ICVOCDFN2*2 AMS 801 U2 |  |  | 2016-12-31
 |  | 11BRANPB20D |  | 删除1V02BRANPL126 金盈佳 1V02BRANPL126 J1,J2,J3 |  |  | 2016-12-31
 |  | 11BRANBB70D |  | 删除R0000R0805 R1 |  |  | 2016-11-01
 |  |  |  | 删除M10MR0605 Q2
 |  |  |  | 删除R0100K0402 R5
 |  |  |  | 增加FUSE2001206 F1
 |  |  |  | DESD6V0201变更为DESD9V2SOD123； |  |  | 2017-04-19
 |  |  |  | MC-100503035-R换成MC-100503036-R |  |  | 2017-07-24
 |  | 11BRANBB70E |  | 删除1V02BRANPL204 金盈佳 1V02BRANPL204 J2，J3，J4 |  |  | 2016-12-31
 |  |  |  | 删除FUSE2001206 万瑞和 smd1206-200 F1
 |  |  |  | 新增FUSE1501206 万瑞和 smd1206-150 F1
 |  | 11BRANVB80A |  | 新增ICVOCQFN6 盛思睿SGPC10 U1，数量为1； |  |  | 2016-12-31
 |  |  |  | 新增C01U5R0402，walsin 0402X105K100CT C1，数量为1；
 |  |  |  | C01U5R0402变更为C01U5R0201 |  |  | 2017-03-18
 |  | 11BRANVB80B |  | ICVOCQFN6 盛思睿SGPC10 更改为SGP30，物料为同一颗 |  |  | 2017-07-27
 |  | 11BRANMB10F |  | C100N7R0402 C253增加 |  |  | 2017-09-21
 |  |  |  | C4U75R0603 C252增加 |  |  | 2017-09-21
 |  |  |  | DESD6V0201 D20增加 |  |  | 2017-09-21
 |  |  |  | CN42361FPC J18增加 |  |  | 2017-09-21
 |  | APPROVED |  | CHECKED | PREPARED |  | ISSUED BY
BY |  | Jemmey |  | Jemmey | Jemmey |  | Jemmey
DATE |  | 2017-08-19
 | PROPRIETARY INFORMATION OF ClearGrass
