ClearGrass/BranHardware/11BRANMB10G/11BRANMB10GSMT文件/06 3D/Bran_Main_Assay_PCB_v2_20170826.step

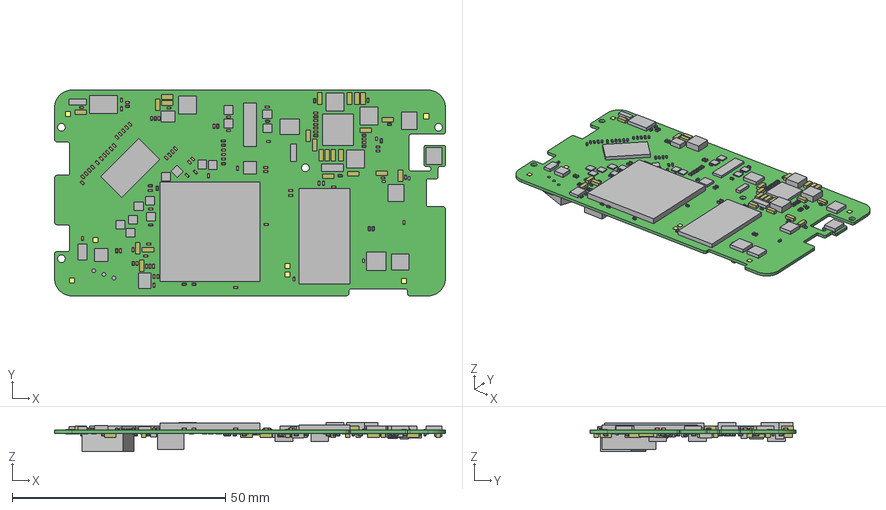
[picture p31: CAD file, 2017-08-29]
11BRANMB10G/11BRANMB10GSMT文件/06 3D/Bran_Main_Assay_PCB_v2_20170826.step
91.7 x 48.3 x 6.85 mm
Board
Extruded x 169
User_Library-0402(1005M)_Cap x 193
