ClearGrass/BranHardware/11BRANMB10G/Temp Sensirion assy FPC/Temp Sensirion assy FPC.step

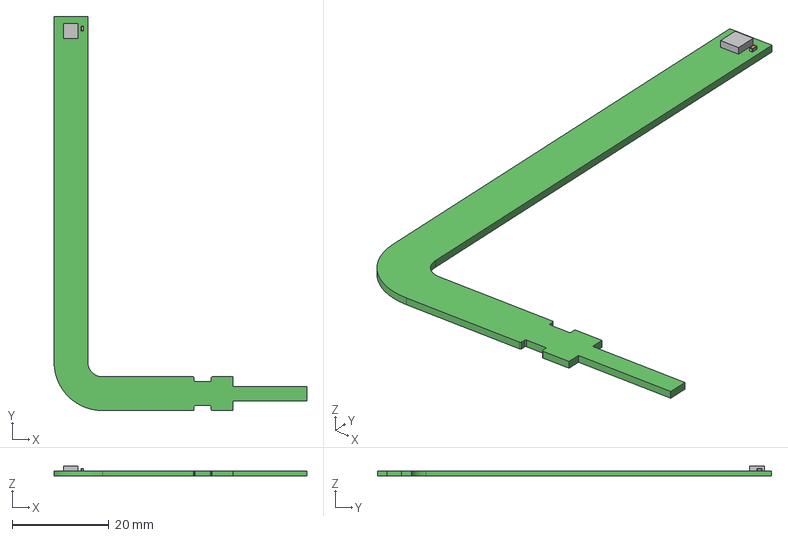
[picture p32: CAD file, 2017-08-29]
11BRANMB10G/Temp Sensirion assy FPC/Temp Sensirion assy FPC.step
52.3 x 81.5 x 2.02 mm
Board
Extruded
User_Library-0402(1005M)_Cap
