ClearGrass/BranHardware/11BRANMB10H2/11BRANMB10H2_SMT文件/05 3D/11BRANMB10H2_20170927.step

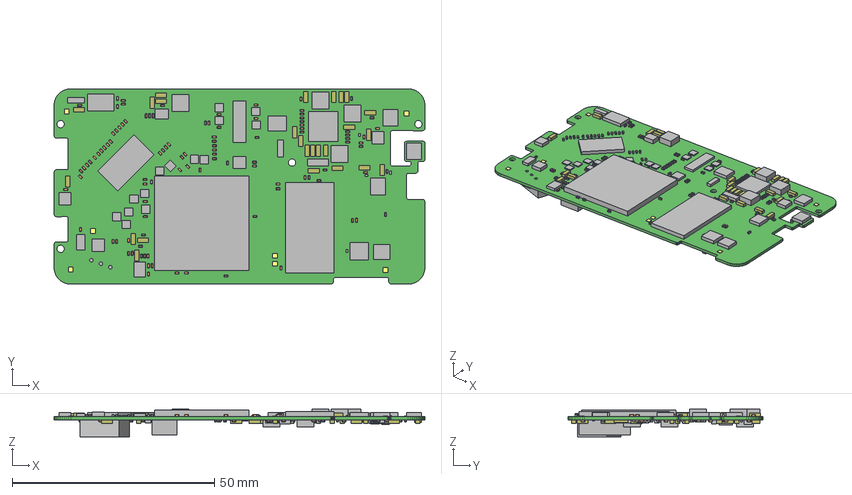
[picture p33: CAD file, 2017-10-13]
11BRANMB10H2/11BRANMB10H2_SMT文件/05 3D/11BRANMB10H2_20170927.step
91.7 x 48.3 x 6.80 mm
Board
Extruded x 171
User_Library-0402(1005M)_Cap x 194
