ClearGrass/BranHardware/(list of files, cad)

Other CAD files:
11BRANMB10G/11BRANMB10GSMT文件/05 2D/Bran_Main_Assay_PCB_v2_20170826.DXF
11BRANMB10G/Temp Sensirion assy FPC/结构/t_fpc_170826.dwg
11BRANMB10H/11BRANMB10H SMT文件/05 3D/11BRANMB10H_20170919.step
11BRANMB10G/Temp Sensirion assy FPC/Temp Sensirion assy FPC.DXF
