ClearGrass/BranHardware/11BRANMB10G/11BRANMB10GSMT文件/02目检图/bot.pdf

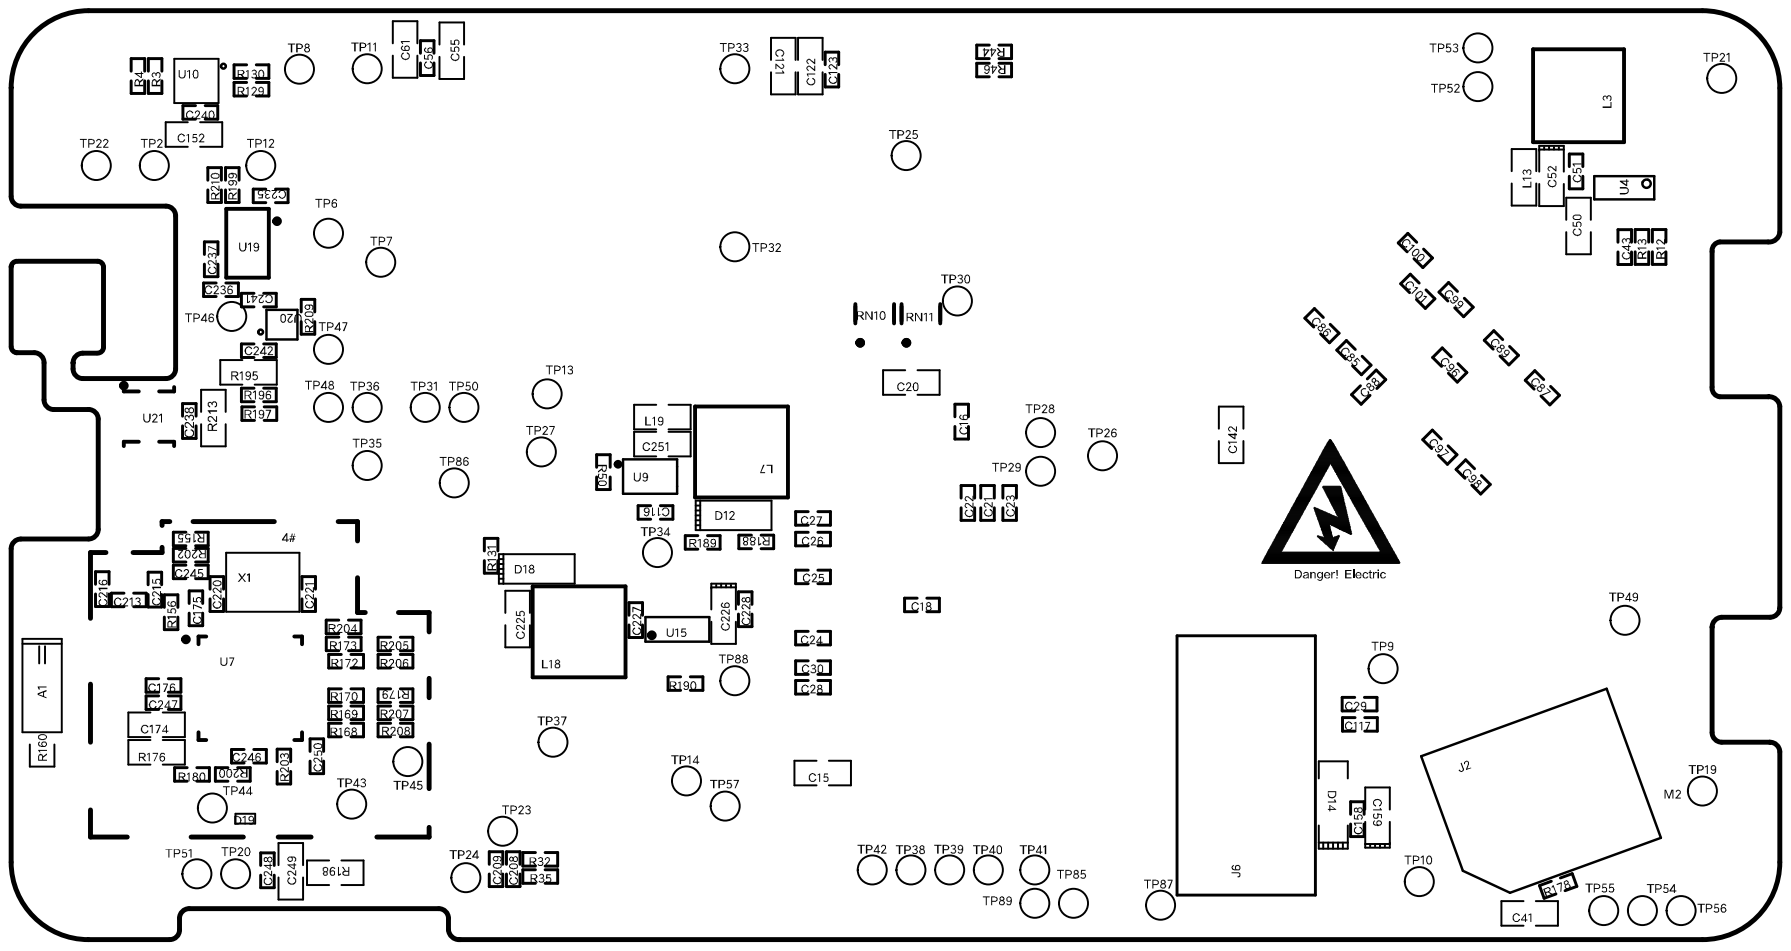
[picture p34: page 1]
