ClearGrass/BranHardware/11BRANMB10G/11BRANMB10GSMT文件/02目检图/top.pdf

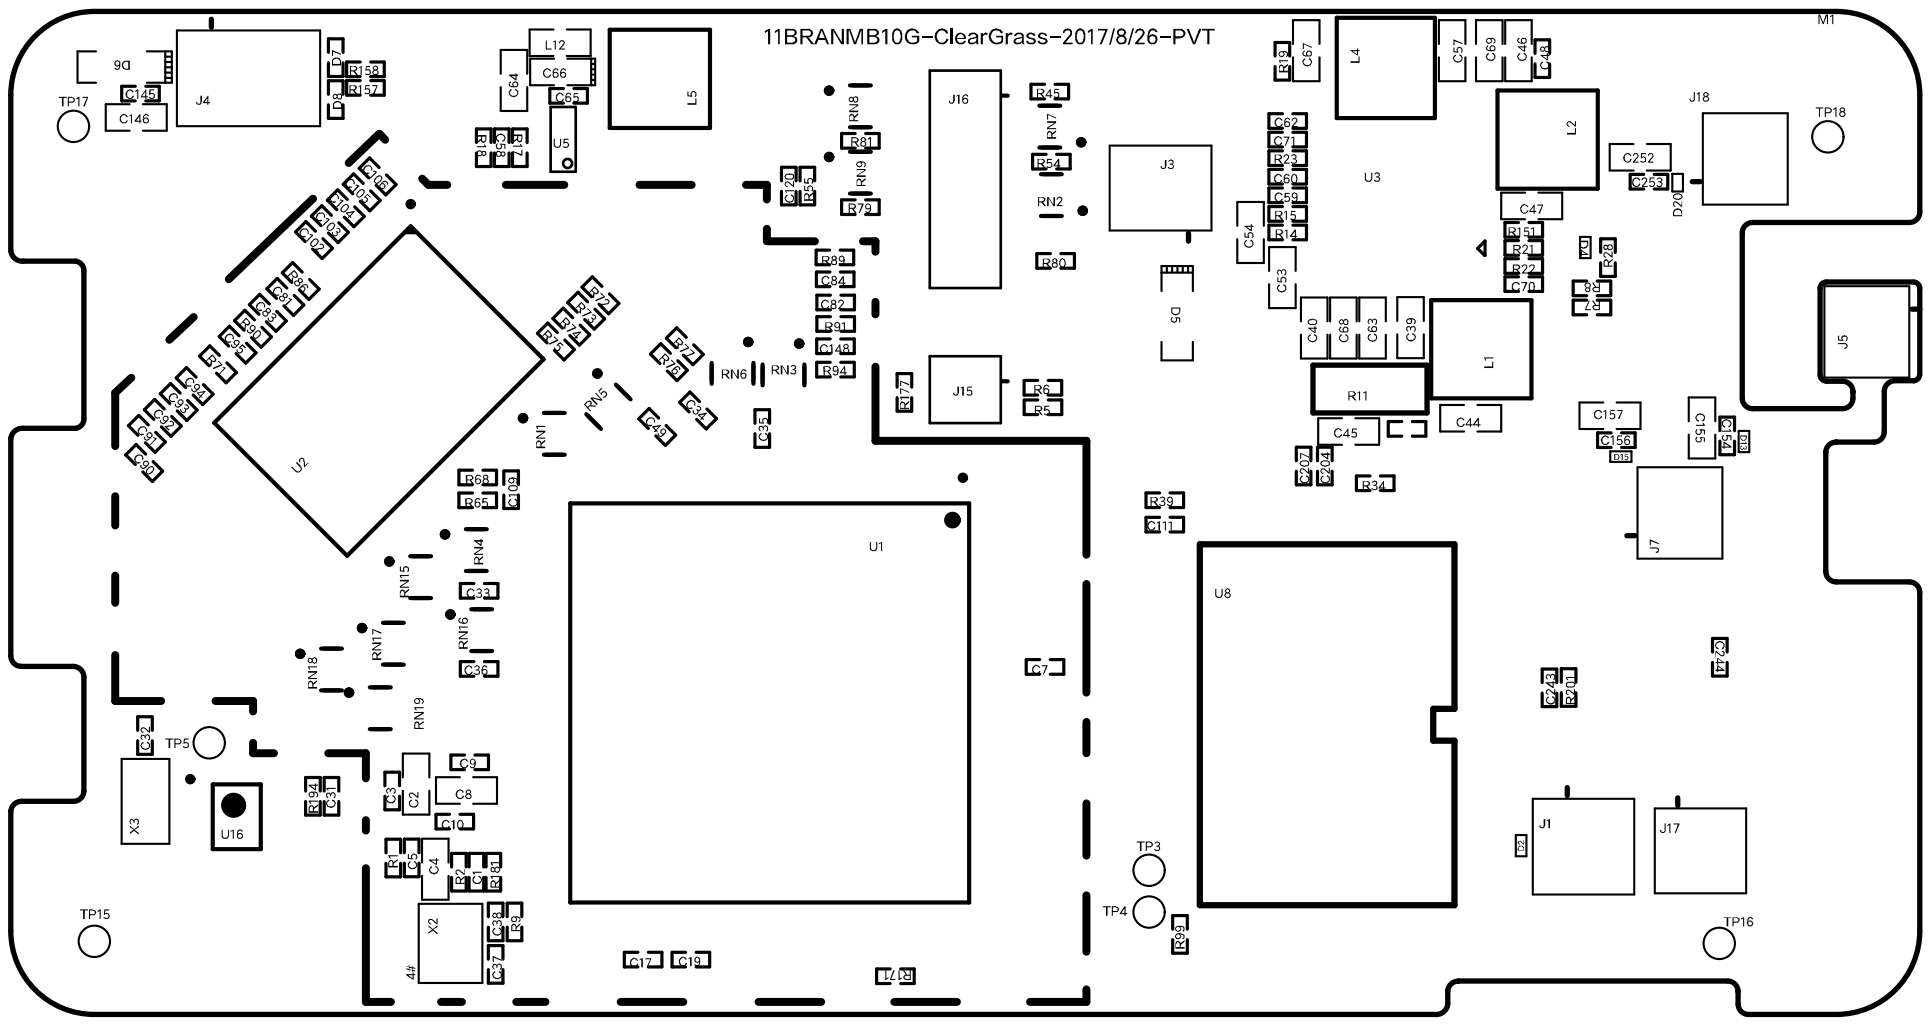
[picture p35: page 1]
