ClearGrass/BranHardware/11BRANMB10H/11BRANMB10H SMT文件/02目检图/bot.pdf

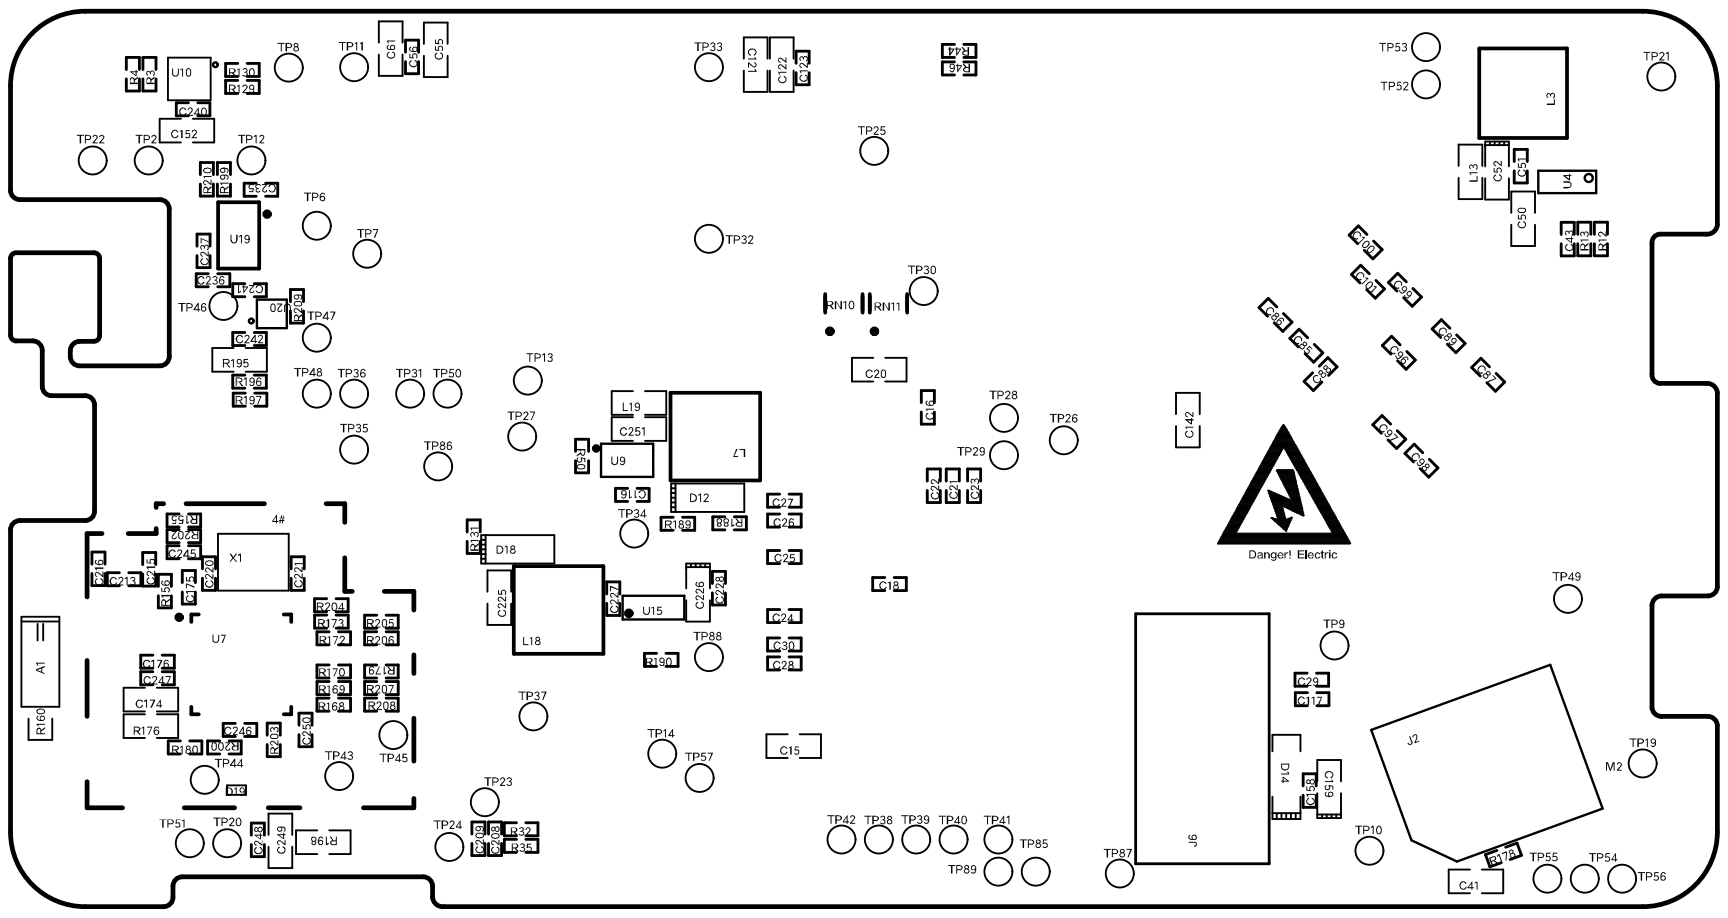
[picture p36: page 1]
