ClearGrass/BranHardware/11BRANMB10H/11BRANMB10H SMT文件/02目检图/top.pdf

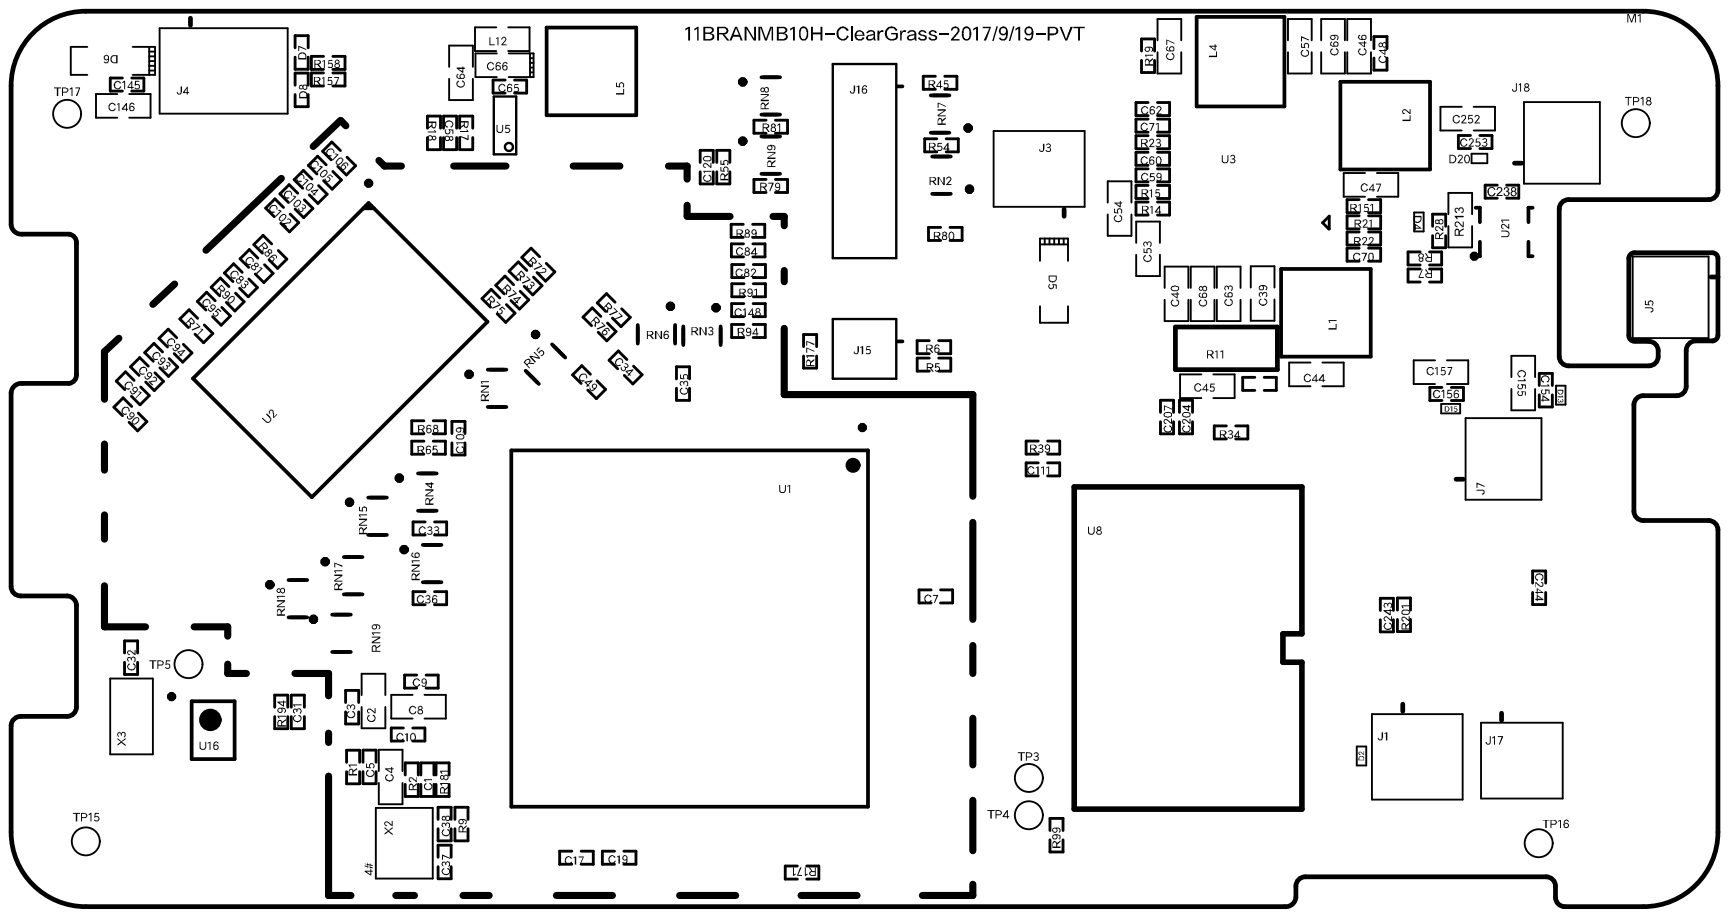
[picture p37: page 1]
