ClearGrass/BranHardware/11BRANMB10H2/11BRANMB10H2_SMT文件/02目检图/BOT.pdf

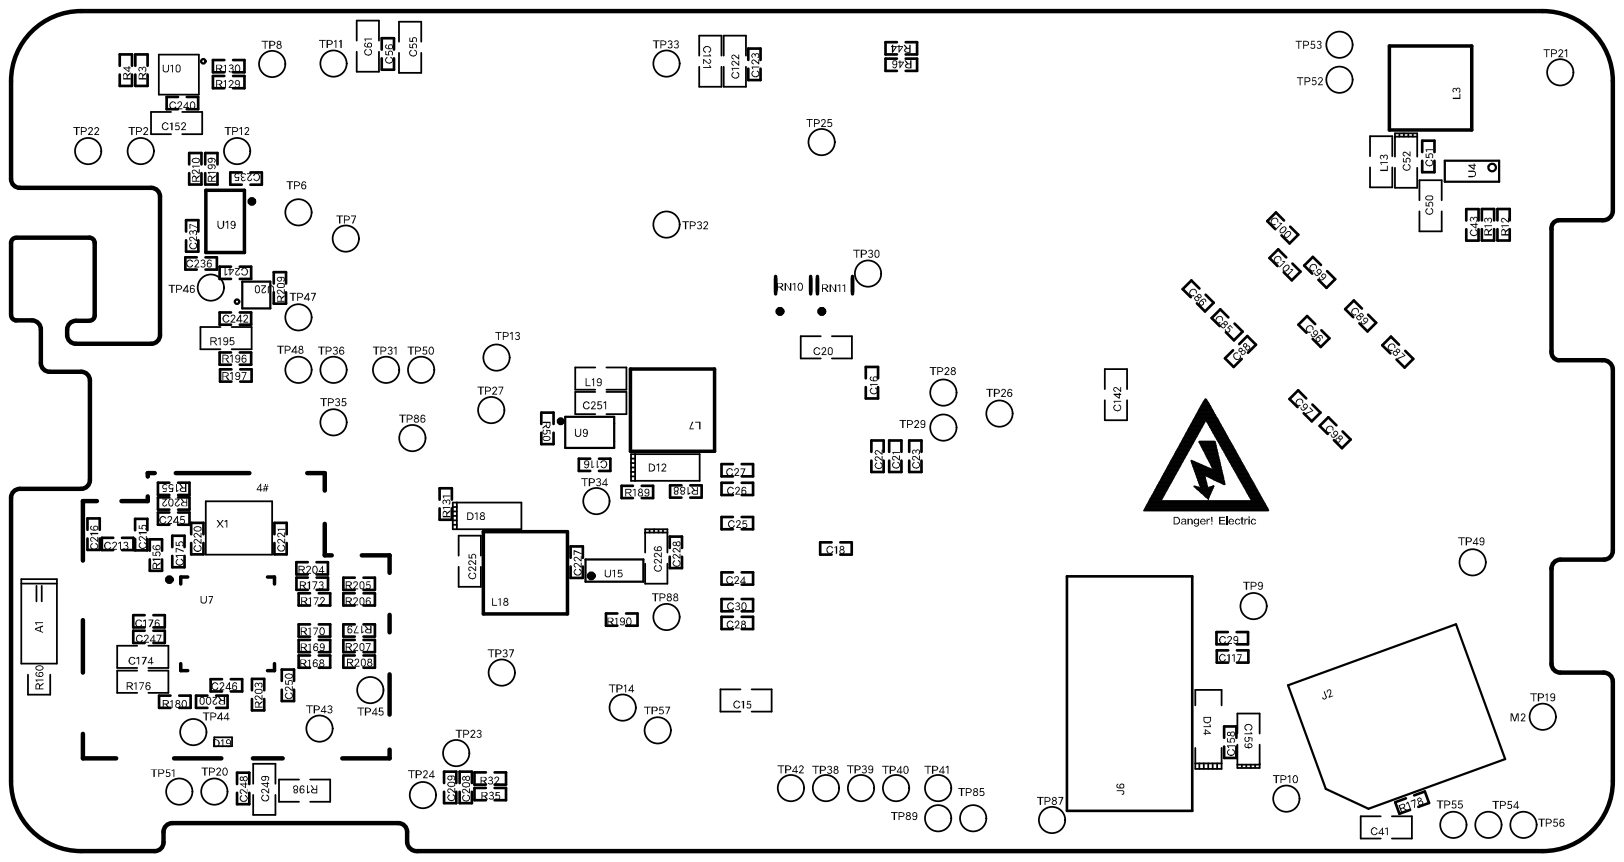
[picture p38: page 1]
