ClearGrass/BranHardware/11BRANMB10H2/11BRANMB10H2_SMT文件/02目检图/TOP.pdf

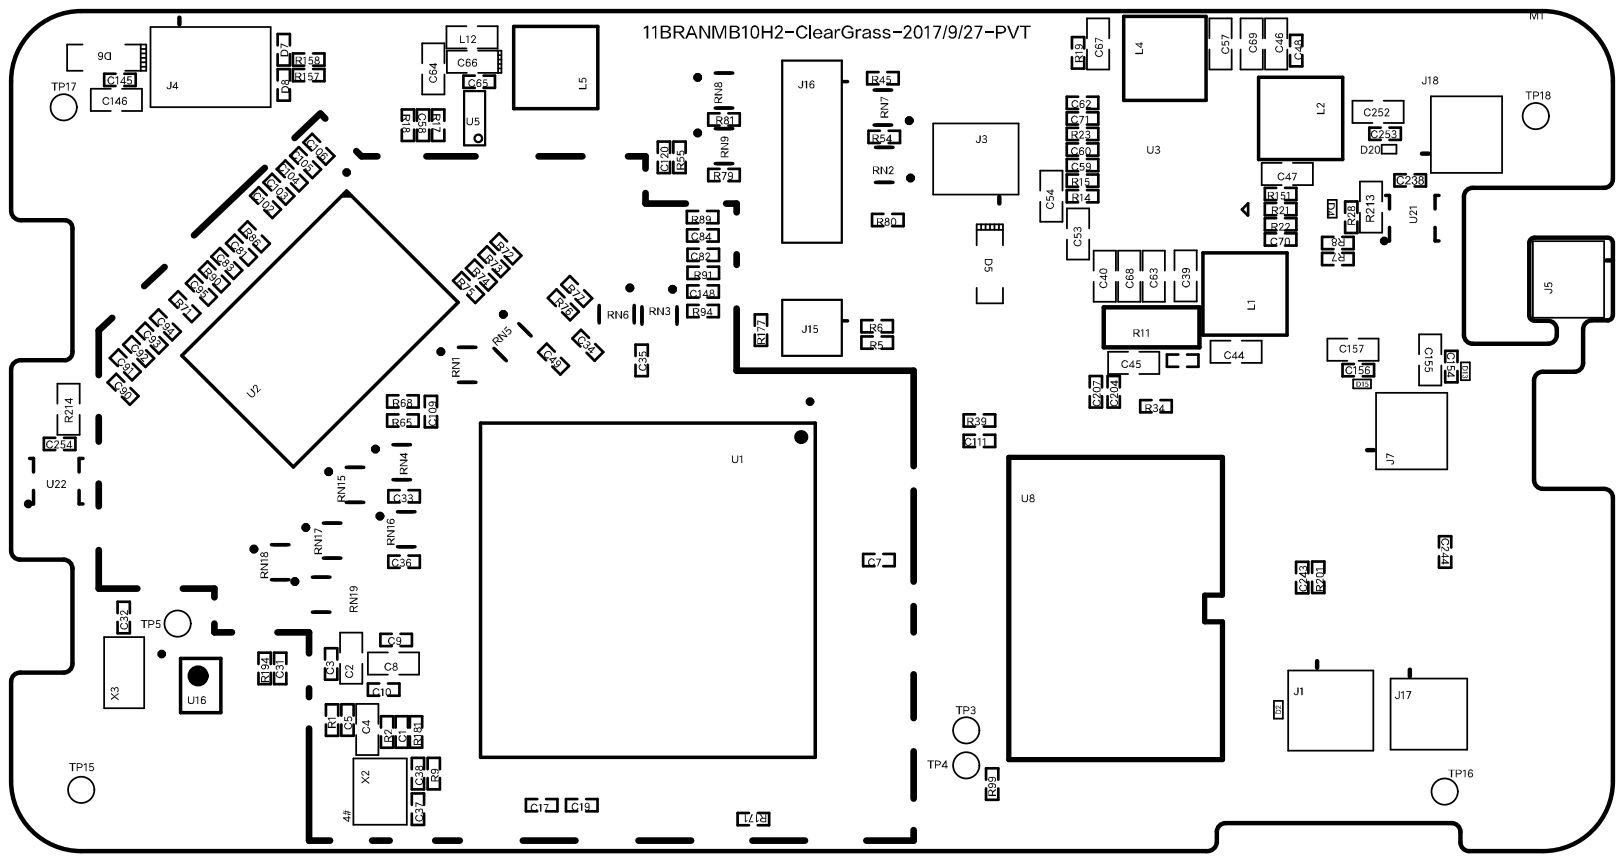
[picture p39: page 1]
