ClearGrass/BranHardware/11BRANMB10G/Temp Sensirion assy FPC/结构/5034800600_sd.pdf

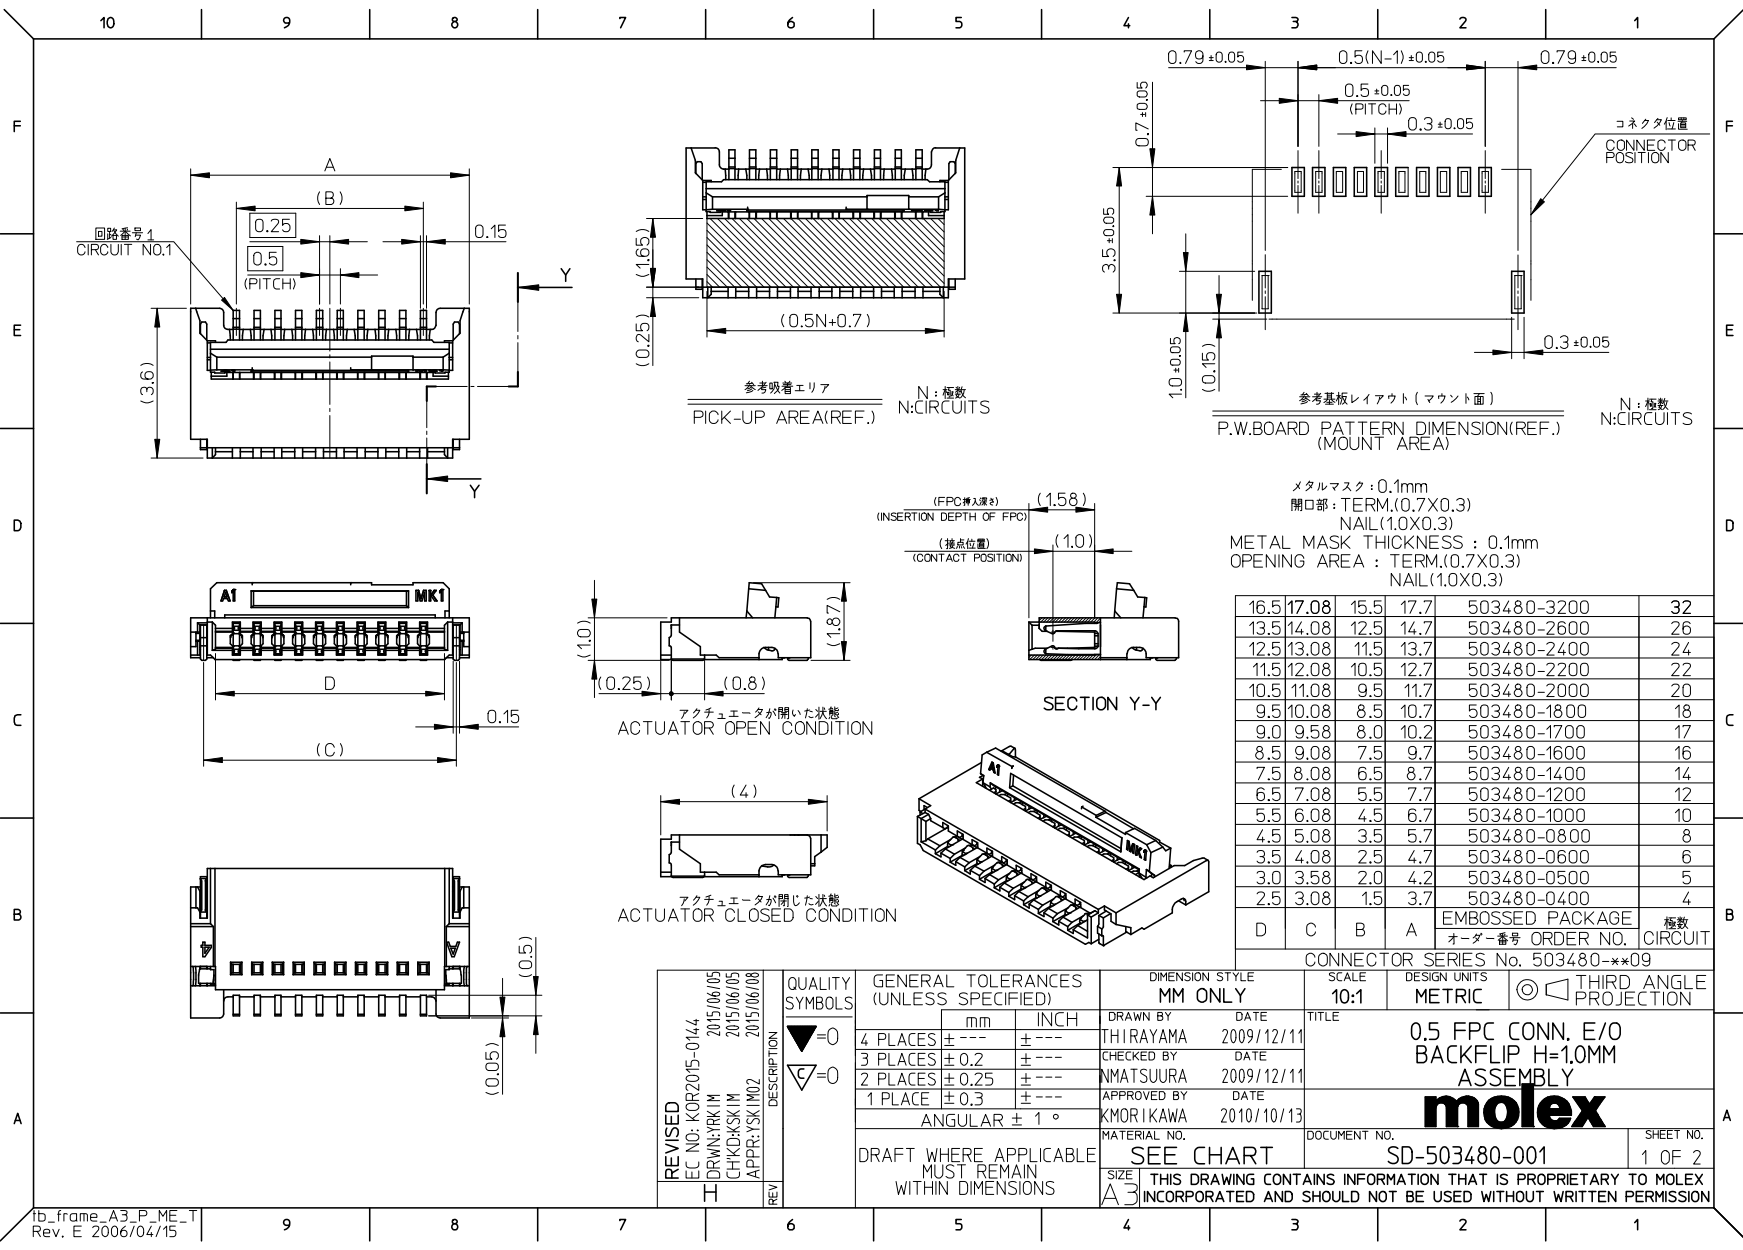
[picture p40: page 1]

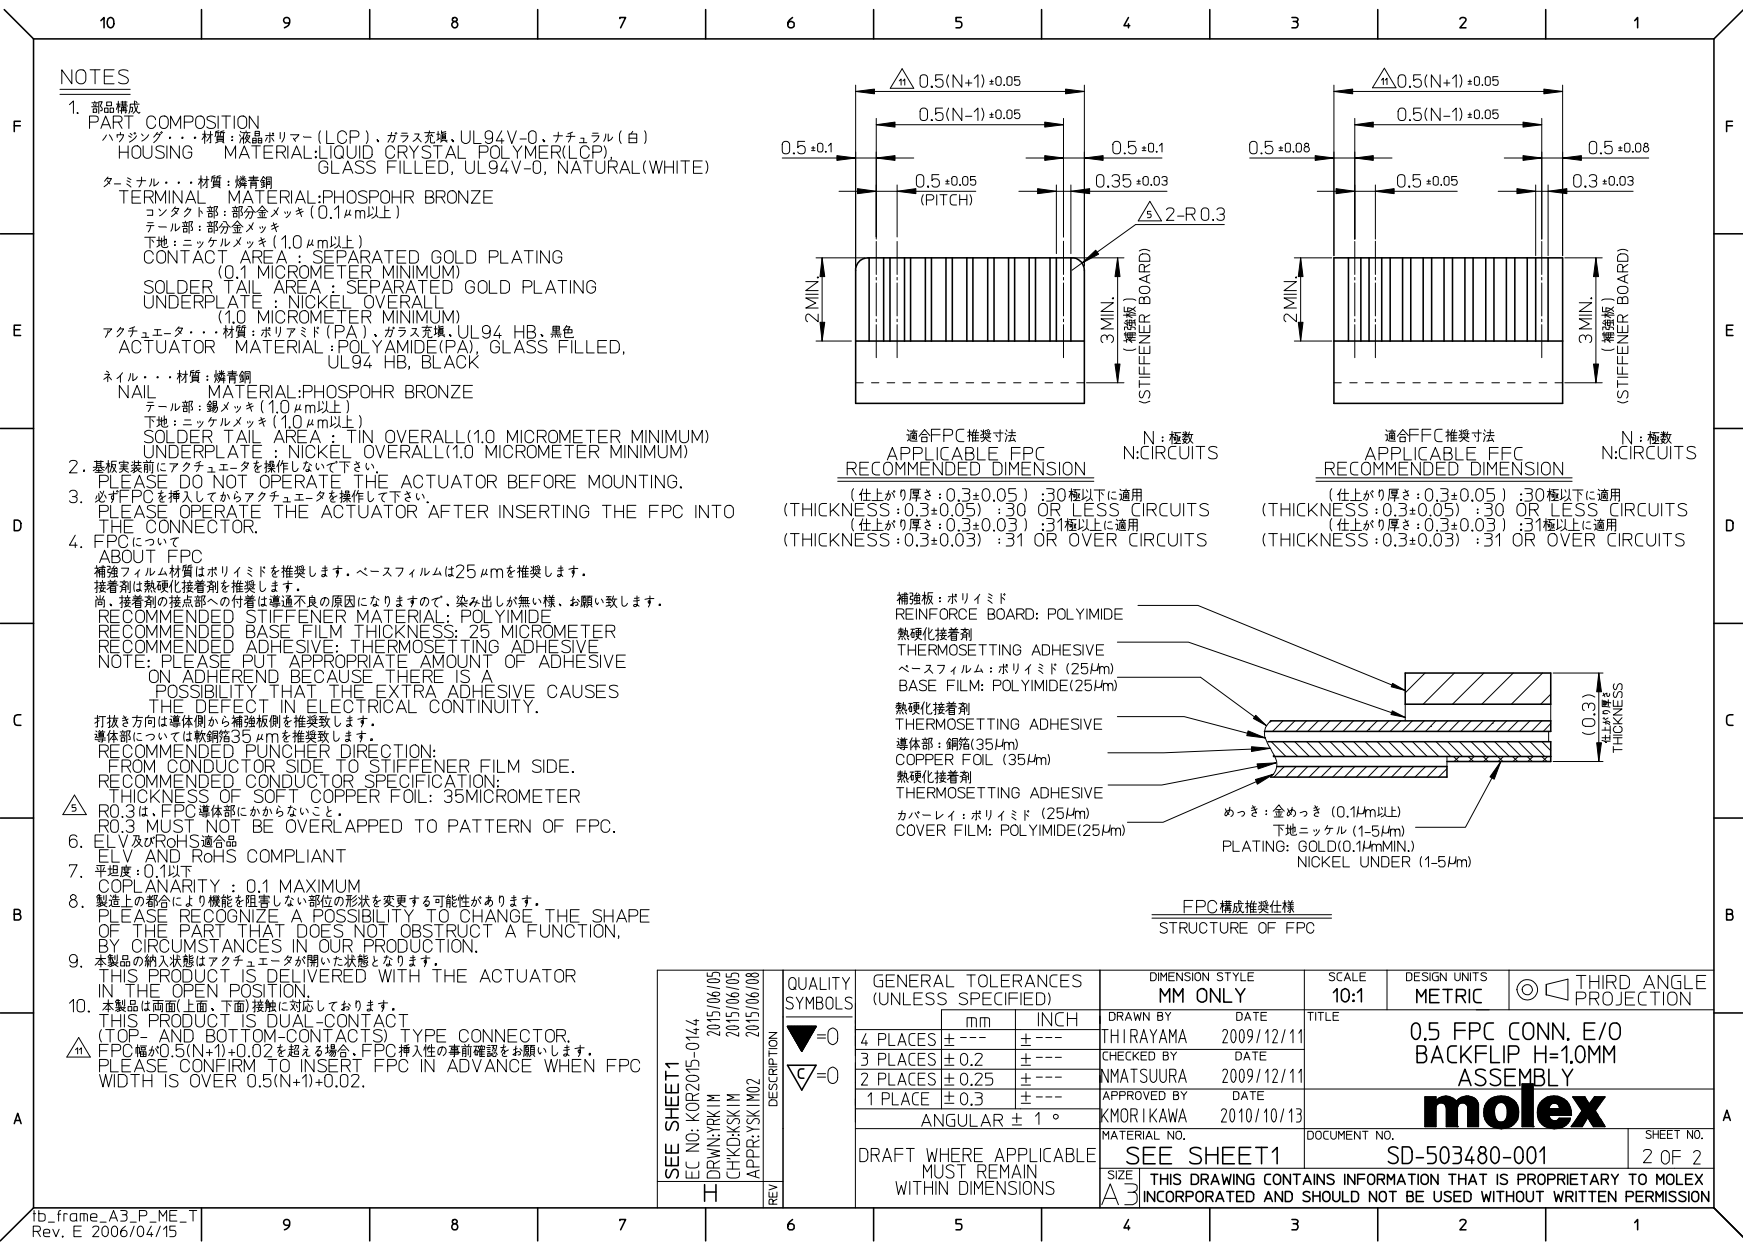
[picture p41: page 2]

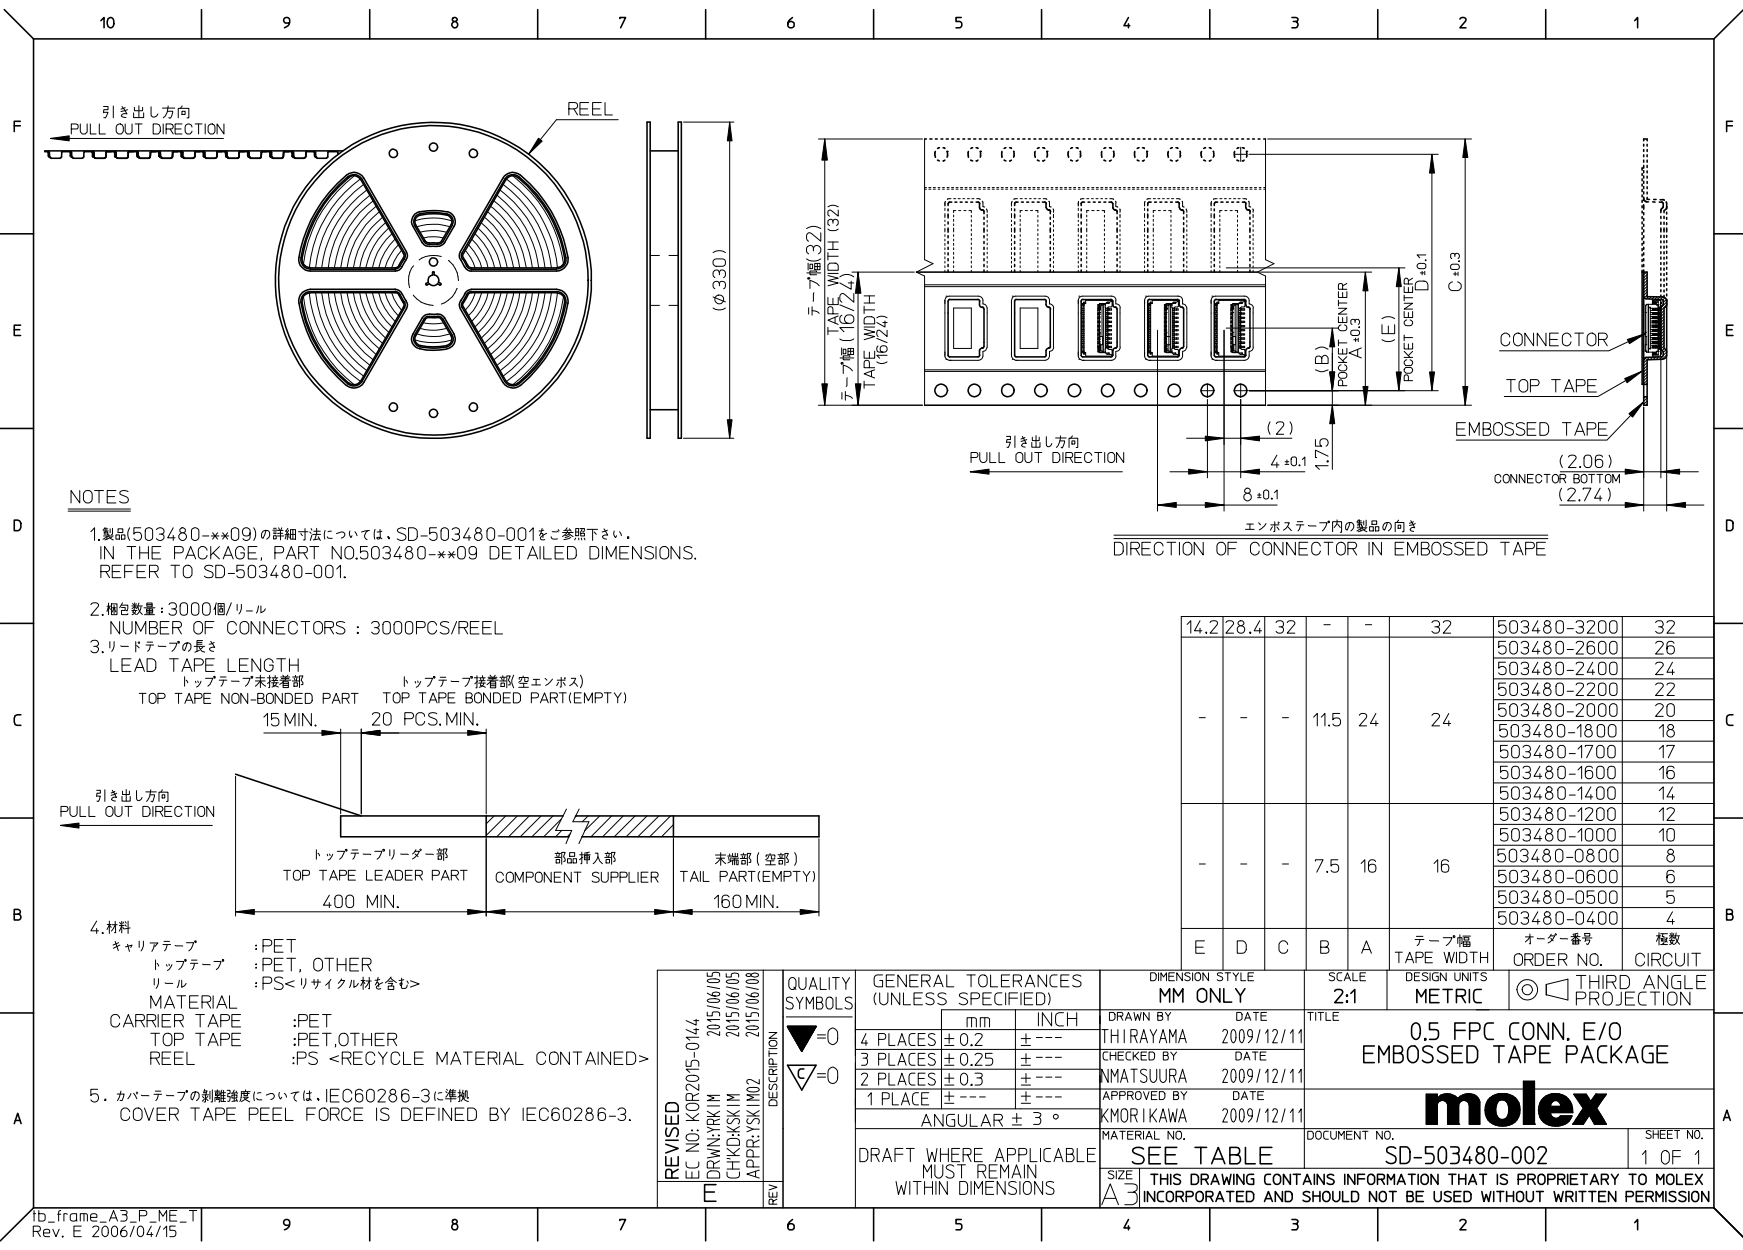
[picture p42: page 3]
