ClearGrass/BranHardware/(list of files, drawings)

Other design files:
11BRANBB70F/base_power_assy PCB_20171028.PcbDoc
11BRANMB10F/PCB/Bran_Main_Assya_PCB_v2.PrjPCB
11BRANMB10G/PCB/Bran_Main_Assya_PCB_v2.PrjPCB
11BRANMB10G/SCH/R8_BRAN_MAIN_PCB_ASSY.DSN
11BRANMB10G/Temp Sensirion assy FPC/Temp Sensirion assy FPC.PcbDoc
11BRANMB10G/Temp Sensirion assy FPC/Temp Sensirion assy FPC.PrjPCB
11BRANMB10G/Temp Sensirion assy FPC/Temp Sensirion assy FPC.SchDoc
11BRANMB10H2/PCB/11BRANMB10H2.PrjPCB
11BRANMB10H2/SCH/R8_BRAN_MAIN_PCB_ASSY.DSN
11BRANMB10H3/温湿度FPC/11BRANSEB30E2.PcbDoc
11BRANMB10H/PCB/Bran_Main_Assya_PCB_v2.PrjPCB
Bran_PVT_Download/Bran_Download.PCBDOC
Bran_PVT_Download/Bran_Download.PrjPcb
Bran_PVT_Download/Bran_Download.SchDoc
Debug-Pinboard/pin board.PcbDoc
