ClearGrass/BranHardware/(commit log)

2016-05-17 增加LCD管脚说明
    [RGB Interface for Bran.xlsx]
2016-05-19 Violet原理图
    [LCD_RGB.SchDoc, M150.SchDoc]
2016-05-19 Jemmey原理图
    [Auxiliary.SchDoc, Bran.PrjPCB, NandFlash.SchDoc, PMU.SchDoc, Peripherals.SchDoc, Power.SchDoc, Wireless.SchDoc]
2016-05-20 增加文件夹说明
2016-05-22 释放压缩包，删除老版本原理图
    [Auxiliary.SchDoc, Bran.PrjPCB, LCD_RGB.SchDoc, M150.SchDoc, M150.SchLib, NandFlash.SchDoc, PMU.SchDoc, Peripherals.SchDoc]
2016-05-22 修改乱码
2016-05-22 删除老版本，更新新版本
    删除老版本，更新新版本
    [Auxiliary.SchDoc]
2016-05-23 用于内部评审_20150522版
    [Auxiliary.SchDoc, LCD_RGB.SchDoc, M150.SchDoc, PMU.SchDoc, Peripherals.SchDoc, Power.SchDoc, Wireless.SchDoc]
2016-05-23 Reply Ingenic ADD sensor
    [Auxiliary.SchDoc, Bran.PrjPCB, LCD_RGB.SchDoc, M150.SchDoc, NandFlash.SchDoc, PMU.SchDoc, Peripherals.SchDoc, Power.SchDoc]
2016-05-23 M150 Pin Map Edit by Violet 20160523
    [M150 Pin Map_201605232204.xlsx]
2016-05-23 Debug Pinboard
    Debug Pinboard
    [Auxiliary.SchDoc, Debug Pinborad.PrjPCB, Debug Pinborad.SCHLIB, Interface Pinboard.SchDoc, LCD_RGB.SchDoc, OL_sensor.SchDoc, Temp.SchDoc]
2016-05-24 Peripherals.schdoc update
    1. J4、J7 SCH LIB封装，将OL\TEMP等信息去除；
    2. J4 I2C_SCL、I2C_SDA 对应的TP28、TP29测试点去除；
    3. J4\J7 I2C网络标号变更为S_I2C_SCL\S_I2C_SDA；
    [Peripherals.SchDoc]
2016-05-24 Auxiliary.schdoc update
    1. 将I2C网络标号变更为S_I2C_SCL\S_I2C_SDA；
    [Auxiliary.SchDoc]
2016-05-24 M150.schdoc update
    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
    [M150.SchDoc]
2016-05-24 删除M150.SchLib
    新增Bran.SchLib
    [M150.SchLib]
2016-05-24 新增Bran.SCHLIB
    后续Bran原理图库文件在Bran.SCHLIB维护；
    [Bran.SCHLIB]
2016-05-24 更新版本
    更新版本
    [Temp.SchDoc]
2016-05-24 版本更新
    版本更新
    [OL_sensor.SchDoc]
2016-05-24 增加Bran PCB LIB
    增加Bran PCB LIB
    [Bran.PcbLib]
2016-05-25 Bran_ADD SPI Interface
    Bran_ADD SPI Interface
    [RGB Interface for Bran_ADD SPI Interface_fool proof design _20160510525.xlsx]
2016-05-25 迭代版本
    迭代版本
    [RGB Interface for Bran.xlsx]
2016-05-26 R8 Plaform 修改部分电路
    [R8_STD_V2_0.DSN]
2016-05-26 删除R8_STD_V2.0.DSN，放入新文件夹"R8"，与君正平台区分
    删除R8_STD_V2.0.DSN，放入新文件夹"R8"，与君正平台区分
    [R8_STD_V2_0.DSN]
2016-05-26 全志R8平台SCH
    全志R8平台SCH
2016-05-26 R8 SCH Update
    R8 SCH Update
    [R8_STD_V2_0.DSN, r8_std_v2_0.opj]
2016-05-27 R8_Bran_V2.0 20150527_ADD sensors Edit by violet
    [R8_Bran_V2_0_20160527.DSN]
2016-05-27 版本更新，以后上传文件迭代覆盖，取名为R8_Bran_Main_PCB_Assy.DSN
    版本更新，以后上传文件迭代覆盖，取名为R8_Bran_Main_PCB_Assy.DSN
    [R8_Bran_V2_0_20160527.DSN]
2016-05-27 增加Wi-Fi XR819部分
    增加Wi-Fi XR819部分
    [R8_Bran_Main_PCB_Assy.DSN]
2016-05-28 Wi-Fi部分增加测试点、电源加跳线，增加BLE部分
    Wi-Fi部分增加测试点、电源加跳线，增加BLE部分
    [R8_Bran_Main_PCB_Assy.DSN]
2016-05-29 5月29号原理图评审加修正
    修改项目较多，将发邮件出来整理。后续两天需要着重评审修改，保证前期将问题点修正。
    [R8_Bran_Main_PCB_Assy.DSN]
2016-05-30 评审再一次修改，20160530 ，eddit by violet
    [R8_Bran_Main_PCB_Assy.DSN]
2016-05-31 评审，修改，20160531
    评审，修改，20160531，六一节日快乐。
    [R8_Bran_Main_PCB_Assy.DSN]
2016-06-01 Create schematic Library
2016-06-01 评审，修改，20160601
    1. PMU pin6 N_VBUSEN接CPU PB4；
    2. Wi-Fi晶振部分负载电容 C196、C197由8PF改为9PF；
    3. R7、R8 2.2K改为4.7K；
    4. CPU JTAG部分加VCC、GND；
    5. Power部分增加1.8V LDO；
    6. Power部分BOOST IC改为RT9266;
    7. 测试点添加；
    [R8_Bran_Main_PCB_Assy.DSN]
2016-06-01 N_VBUSEN下拉
    N_VBUSEN下拉
    [R8_Bran_Main_PCB_Assy.DSN]
2016-06-01 增加PDF文档，方便评审
    增加PDF文档，方便评审
2016-06-02 20160602变更
    1. PMU LCD_BL_EN 接GPIO1删除；
    2. 将DEBUG_LED3外设剔除；
    3. 将R150 CHGLED与DEBUG_LED3之间跳线剔除；
    4. 修改U6元器件号；
    5. BOOT更改为单个跳线；
    6. PM2.5接口顺序变更；
    [R8_Bran_Main_PCB_Assy.DSN]
2016-06-02 初始版本---功能性 map 有些细节还需要再更新
    [RGB Interface for Bran_ADD SPI Interface_fool proof design _changeR&B_20160510526.xlsx]
2016-06-02 2016.6.2 评审修改
    1. 修改BOOT电路；
    2. 修改COVER PAGE；
    3. 将LDO1剔除，接RTCVDD；将LDO3接至CPU IO\NAND；将LDO4接至Sensor;将外围Buck 输出至BLE；
    4. Boost IC EN接CPU PG1；
    5. DEBUG_LED1\DEBUG_LED2\DEBUG_LED3接TPY1\TPX1\TPY2；
    6. PM2.5 RESET 去除，CPU PM2.5 TX.RX互换；
    7. USB0-IDET接PG2；
    [R8_Bran_Main_PCB_Assy.DSN]
2016-06-03 20160603变更
    1. Cover 2.8V改为3.3V；
    2. USB换为8 PIN FPC连接器；
    3. 元器件标号重新排列；
    [R8_Bran_Main_PCB_Assy.DSN]
2016-06-03 版本管理，放入LIB文件夹
    版本管理，放入LIB文件夹
2016-06-03 添加Cadence LIB
2016-06-04 20160604变更
    1. 增加C201 0.1uF电容；
    2. COVER页更改；
    3. Sensor部分加3个TVS二极管 VMNZC68CST2RA；
    4. USB部分增加600R-500MA磁珠；
    5. BUCK IC:IPSOUT-3.3V串接 600R-1.5A磁珠，BUCK IC:IPSOUT-1.5V 串接 600R-1.5A磁珠；
    6. BLE-VDD改为VCC_3.3V；
    7. R129 0R-1%，改为R154 0R-1%；
    8. GND加测试点；
    9. 增加两个Bad Mark点M1，M2；
    10. 元器件标号规范设计；
    [R8_Bran_Main_PCB_Assy.DSN]
2016-06-04 20160604 BOM生成
    Bran R8平台 20160604 BOM生成
    [Bran SMT BOM20160603.xlsx]
2016-06-06 删除0603版本，增加0606版本
    [Bran SMT BOM20160603.xlsx, Bran SMT BOM20160606.xlsx]
2016-06-07 工具for PADS9.5
    工具for PADS9.5
2016-06-08 PCB布局完成
    PCB布局完成
    [Bran.PcbLib, Debug Pinborad.PrjPCB, LCD_RGB.SchDoc, PCB1.PcbDoc, Sensor.SchDoc]
2016-06-08 Delete R8_Bran_Main_PCB_Assy.DSN
    增加新版本V01删除旧版本
    [R8_Bran_Main_PCB_Assy.DSN]
2016-06-08 Bran PCB布局以及问题点整理
    Bran PCB布局以及问题点整理
    [R8_V1_1-4Layer.pcb]
2016-06-11 Wi-Fi&BLE修正
    Wi-Fi :1. 更正VCC-WiFi-1.8V与VCC-IO-WIFI 网络接错Bug；2.增加VCC-WiFi-3V3小容量电容；
    BLE：增加VDD NC部分；
    [R8_Bran_Main_PCB_Assy_V01.DSN, r8_bran_main_pcb_assy_v01.opj]
2016-06-11 Wi-Fi/BLE修正
    Wi-Fi部分 R155上拉接至PIN21；
    PIN19接至GND；
    BLE部分增加蓝牙天线模组 A2，C205【π滤波调理电路】
    更新PDF文档；
    [R8_Bran_Main_PCB_Assy_V01.DSN, r8_bran_main_pcb_assy_v01.opj]
2016-06-12 信号部分走完。剩下电源部分。预计今天晚点儿能搞定。布局部分先由季彬来check。
    [R8_V1_1-6Layer.pcb]
2016-06-12 原理图变更
    1. 删减R134；
    2. BLE部分10uH天线更改为0603；
    [R8_Bran_Main_PCB_Assy_V01.DSN, r8_bran_main_pcb_assy_v01.opj]
2016-06-12 修改不对的网络名以及封装
    [R8_Bran_Main_PCB_Assy_V02.DSN]
2016-06-12 原理图同步变更
    由于未同步变更原理图 ，导致版本有误，将WIFI/BLE部分同步更新。
    [R8_Bran_Main_PCB_Assy_V01.DSN, R8_Bran_Main_PCB_Assy_V02.DSN, r8_bran_main_pcb_assy_v01.opj, r8_bran_main_pcb_assy_v02.opj]
2016-06-12 转接板新需求增加
    转接板新需求增加
    [Auxiliary.SchDoc, Bran PinBoard.PrjPCB, Bran PinBoard.SCHLIB, LCD_RGB.SchDoc, Sensor.SchDoc, r8-dev-v1.0-20151028.opj]
2016-06-12 元器件标号变更
    元器件标号变更
    [Bran PinBoard.PrjPCB, LCD_RGB.SchDoc, Sensor.SchDoc]
2016-06-12 增加安森美光线传感器部分
    增加安森美光线传感器部分
    [Bran PinBoard.SCHLIB, LCD_RGB.SchDoc, Sensor.SchDoc]
2016-06-12 原理图、封装变更
    根据陆超修改意见，更改原理图；
    添加增加部分对应PCB封装；
    [Bran PinBoard.PrjPCB, Bran.PcbLib, LCD_RGB.SchDoc, Sensor.SchDoc, r8-dev-v1.0-20151028.opj]
2016-06-12 原理图更改，PCB封装添加
    根据陆超反馈，将原理图问题点更改；
    对应FPC连接器封装增加；
    [522713079.stp, Bran PinBoard.PrjPCB, Bran.PcbLib, LCD_RGB.SchDoc, Sensor.SchDoc, cases.cfg, pin board.PcbDoc, r8-dev-v1.0-20151028.opj]
2016-06-13 增加蓝牙的EPAD
    [R8_Bran_Main_PCB_Assy_V02.DSN]
2016-06-13 根据全志反馈更改
    根据全志反馈更改
    [R8_Bran_Main_PCB_Assy_V02.DSN, r8_bran_main_pcb_assy_v02.opj]
2016-06-13 PCB LAYOUT完成
    [Bran.PcbLib, pin board.PcbDoc]
2016-06-13 原理图更新
    原理图参考原理图修改意见.docx文档；
    [R8_Bran_Main_PCB_Assy_V02.DSN, r8_bran_main_pcb_assy_v02.opj]
2016-06-13 结构上确认要做调整，电路上根据全志给出的意见也要做修改。预计明天可以发板子。
    [R8_V1_1-6Layer_bran_201606132208.pcb]
2016-06-13 PM2.5接2.54*4跳线接口，发板
    [Bran PinBoard.SCHLIB, GPIO Pinmap.xlsx, LCD_RGB.SchDoc, R8-DEV-V1.0-20151028.DSN, Sensor.SchDoc, pin board.PcbDoc, r8-dev-v1.0-20151028.opj]
2016-06-13 R11更改为1206封装；
    R11更改为1206封装；
    [R8_Bran_Main_PCB_Assy_V02.DSN, r8_bran_main_pcb_assy_v02.opj]
2016-06-14 修改未连接的net，增加1.8V的供电方案
    [R8_Bran_Main_PCB_Assy_V02 .DSN]
2016-06-14 删除旧版本，新版本更改；
    1. 30MR电阻变更为1206封装；
    2. CPU TWI-PULLUP SENSOR-VDD去除；
    [R8_Bran_Main_PCB_Assy_V02 .DSN, R8_Bran_Main_PCB_Assy_V02.DSN, r8_bran_main_pcb_assy_v02 .opj, r8_bran_main_pcb_assy_v02.opj]
2016-06-14 变更
    1. BOM变更；
    WR04X000PTL，单机用量变更为9；
    60R变更为60.4R，料号变更为WR04X60R4FTL；
    30mR封装变更为1206，料号变更为WW12WR030FTL；
    BLM18KG601SN1D新增L14；
    41Pin 0.3mm间距改为广濑连接器FH34SRJ-40S-0.5SH(50)；
    增加ANT24503216 A2，单机用量增至2；
    增加0402N220J500CT C204，单机用量增至2；
    删除WR04X1002FTL R134，单机用量减至13；
    L8改为LQM18FN100M00#；
    2. 原理图 USB部分、PM2.5部分新增TVS二极管；
    [Bran SMT BOM20160606.xlsx, Bran SMT BOM20160614.xlsx, R8_Bran_Main_PCB_Assy_V02 .DSN, r8_bran_main_pcb_assy_v02 .opj]
2016-06-14 已经完成功能性检测无错误。需要季彬帮忙调整下结构上的问题
    [R8_V1_1-6Layer_bran_201606142130_ without error.pcb]
2016-06-18 修正PWM 写错管脚的问题，用于全志调试Pin board
    [R8 dev_ pin map for bran_20160618.xlsx]
2016-06-18 根据全志修改意见，重新定义了一些Pin脚，根据这个生成新的pinmap
    [R8 Pin Map_20160618.xlsx]
2016-06-19 Pin map增加history项，用于记录每次修改结果。
    [Bran Pin Map.xlsx, R8 dev_ pin map for bran.xlsx]
2016-06-19 针对pin board 制作pin map，增加hostory文件项
    [R8 dev_ pin map for bran.xlsx]
2016-06-19 删除pin board的pinmap
    [R8 dev_ pin map for bran.xlsx]
2016-06-19 删除之前的pinmap
    [M150 Pin Map_201605232204.xlsx]
2016-06-22 增加ignore
2016-06-28 新建PADS9.5 PCB初版文件夹
    新建PADS9.5 PCB初版文件夹
2016-06-28 增加01 pcb_power_assy FPC
    增加01 pcb_power_assy FPC
2016-06-28 增加 01 pcb_power_assy fpc
    增加 01 pcb_power_assy fpc
2016-06-28 增加02 sensirion_assy fpc
    增加02 sensirion_assy fpc
2016-06-28 增加03 mic_usb_assy fpc
    增加03 mic_usb_assy fpc
2016-06-28 增加04 key_pcb_assy fpc
    增加04 key_pcb_assy fpc
2016-06-28 增加05 ol_sensor_assy fpc
    增加05 ol_sensor_assy fpc
2016-06-28 增加06 base_poewr_assy_pcb
    增加06 base_poewr_assy_pcb
2016-06-28 整理Github BranHardware文件list
    整理Github BranHardware文件list
    [Bran Pin Map.xlsx, Bran SMT BOM20160614.xlsx, Bran SMT BOM20160627.xlsx, GPIO Pinmap.xlsx, R8 Pin Map_201606072220.xlsx, R8 Pin Map_20160618.xlsx, R8 dev_ pin map for bran.xlsx, R8 dev_ pin map for bran_20160618.xlsx]
2016-06-28 修改ignore
2016-06-28 用于比较R8开发平台与Bran的异同点，方便目前的开发调试以及将来的移植
    [R8 Dev with Bran_Pin map.xlsx]
2016-06-29 修改部分R8与AXP209之间的连接说明
    [R8 Dev with Bran_Pin map.xlsx]
2016-06-29 PCBA测试报告为调试、测试参考依据；
    PCBA测试报告为调试、测试参考依据；
2016-06-30 bran的硬件测试项目文档V01版
    [bran test V01.xls]
2016-07-01 修改main 页内容
    [bran test V01.xls]
2016-07-05 更改LCD-RESET接到BL-EN BUG
    [Bran PinBoard.PrjPCB, LCD_RGB.SchDoc, Sensor.SchDoc, r8-dev-v1.0-20151028.opj]
2016-07-15 Create 苏州明皜
2016-07-15 上传规格书
2016-07-19 增加24MHZ以及26MHZ规格书
    增加24MHZ以及26MHZ规格书
2016-07-28 上传CPU GPIO配置表格
2016-07-31 P1.5变更
    [R8_BRAN_MAIN_PCB_ASSY.DSN, R8_BRAN_MAIN_PCB_ASSY.opj]
2016-08-03 P1.5原理图以及PCB更新
    [Bran_Main_Assay_PCB_v1.GBL, Bran_Main_Assay_PCB_v1.GBO, Bran_Main_Assay_PCB_v1.GBP, Bran_Main_Assay_PCB_v1.GBS, Bran_Main_Assay_PCB_v1.GKO, Bran_Main_Assay_PCB_v1.GTL, Bran_Main_Assay_PCB_v1.GTO, Bran_Main_Assay_PCB_v1.GTP]
2016-08-11 P2原理图评审
    [R8_BRAN_MAIN_PCB_ASSY.DSN, R8_BRAN_MAIN_PCB_ASSY.opj]
2017-07-25 文件更新
    [522713079.stp, Auxiliary.SchDoc, Bran Pin Map.xlsx, Bran PinBoard.PrjPCB, Bran PinBoard.SCHLIB, Bran SMT BOM20160627.xlsx, Bran.PcbLib, Bran.PrjPCB]
2017-07-26 增加了温度传感器
2017-08-21 增加最终版
    [Bran_Main_Assya_PCB_v2.PrjPCB]
2017-08-29 增加外接温湿度传感器PCB
    [Bran_Main_Assay_PCB_v2_20170826.DXF, Bran_Main_Assay_PCB_v2_20170826.step, Bran_Main_Assya_PCB_v2.PrjPCB, R8_BRAN_MAIN_PCB_ASSY.DSN, Temp Sensirion assy FPC.DXF, Temp Sensirion assy FPC.PcbDoc, Temp Sensirion assy FPC.PrjPCB, Temp Sensirion assy FPC.SchDoc]
2017-10-13 增加双温湿度传感器PCB资料
    [11BRANMB10H2.PrjPCB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]
2017-10-27 资料整理及添加各版本之间的联系，
    [11BRANMB10H2.PrjPCB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]
2017-10-31 增加11BRANMB10H3版本PCB及FPC
    [11BRANMB10H3.PrjPCB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]
2017-10-31 增加新版电源底座板（结构固定孔更新）PCB
    [158se25407b0.drl, base_power_assy PCB_20171028.GBL, base_power_assy PCB_20171028.GBS, base_power_assy PCB_20171028.GKO, base_power_assy PCB_20171028.GTL, base_power_assy PCB_20171028.GTO, base_power_assy PCB_20171028.GTP, base_power_assy PCB_20171028.GTS]
2017-11-01 增加Bran_Download治具PCB及原理图资料
    [Bran_Download.PCBDOC, Bran_Download.PrjPcb, Bran_Download.SchDoc]
2017-11-01 上传电源底座F版本PCB工作稿
    [158pe25407a0.drl]
